EpsLeonid/lxe-twr/LXe_digitizer/TA12.jpg

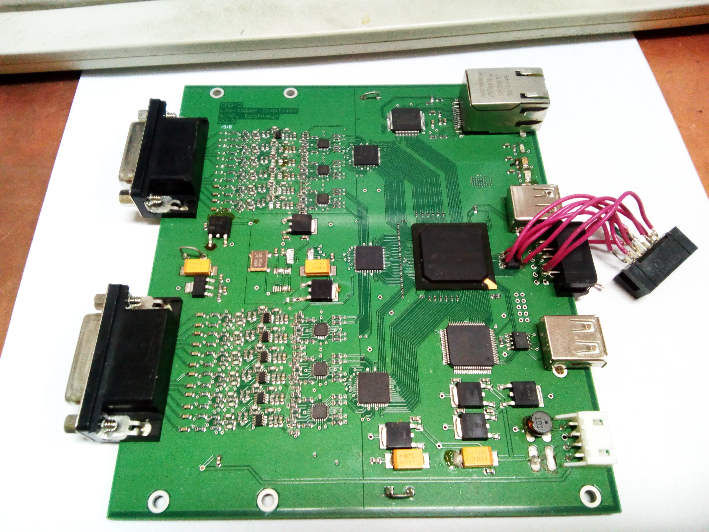
LXe_digitizer/TA12.jpg
