EpsLeonid/lxe-twr/IPT-LXe/Распайка/MyProject_BOM.xls

Designator | Footprint | Comment | Quantity | Layer | Rotation
UApu1 | PQFP-240 | EP3C25Q240C8N | 1 | Top | 270
