EpsLeonid/lxe-twr/IPT-LXe.xls

Comment | Description | Designator | LibRef | Quantity
0.1M |  | CApu1, CApu2, CLED, CLED1, CLED2, CLED3 | C | 6
0.1mkF |  | CCam2, CCam3, CCam4, CCam5 | C | 4
0.1 uF | Capacitor | C21, C22, C23, C24, C25, C26, C27, C29, C30, CAl1, CAl2, CAl3, CAl4, CAl5, CAl6, CAl7, CAl8, CAl9, CAl10, CAl11, CAl12, CAl13, CAl14, CAl15, CAl16, CApll1, CApll2, CApll3, CApll4 | C, Cap | 29
0.1uF |  | C1, C2, C3, C4, C5, C8, C9, C10, Cclk1, Cds1, Cgen1, Cser1, CSL3 | C | 13
1k |  | R1, R2, R3, R4 | R | 4
1K2 |  | RSL1, RSL4, RSL5, RSL8 | R | 4
1 nF |  | C31, C32, C33 | C | 3
2.2M |  | CApu3 | C | 1
5 V926(PLL) |  | UG3 | 5V926(PLL) | 1
10k |  | RApu1, RApu2, RApu3, Rpu1, Rpu2, Rpu3, Rpu4 | R | 7
10 uF |  | CApll5 | C POL | 1
12k |  | R9, R10 | R | 2
51 |  | R5, R6, R7, R8 | R | 4
56 |  | RSL2, RSL3, RSL6, RSL7 | R | 4
100mkF |  | CCam1, Csup2, Csup4, Csup7, Csup10, Csup13 | C POL | 6
200 |  | RLED1 | R | 1
300 |  | R11, R12, Rds4, RLED2, RLED3, Rser4, RSL9 | R | 7
BAV99 | Double diode | VD1, VD2 | BAV99 | 2
CAMAC | CAMAC module | P1 | CAMAC | 1
DM-2.4 |  | L1 | INDUCTOR | 1
DR |  | L4, L5 | L | 2
DS36C200 |  | UL1, UL2 | DS36C200 | 2
DS90LV001TM | 800 Mbps LVDS Buffer, 8-pin Narrow SOIC | Ds3, USer2 | DS90LV001TM | 2
DS92LV16TVHG | 16-Bit Bus LVDS Serializer/Deserializer - 25 - 80 MHz, 80-pin LQFP | UFL1, UFL2 | DS92LV16TVHG | 2
DS92LV1021AMSA | 16 MHz - 40 MHz 10-Bit Serializer, 28-pin SSOP-EIAJ | USer1 | DS92LV1021AMSA | 1
DS92LV1212AMSA | 16 MHz - 40 MHz 10-Bit Bus LVDS Random Lock Deserializer with Embedded Clock Recovery, 28-pin SSOP-EIAJ | Ds1 | DS92LV1212AMSA | 1
EP3C25Q240C8N | Cyclone III Family FPGA, 148 I/O Pins, 4 PLLs, 240-Pin PQFP, Speed Grade 8, Commercial Grade, Pb-Free | UApu1 | EP3C25Q240C8N | 1
EPCS4 | Serial configuration device for Cyclone (Altera) | UApu2 | EPCS1 | 1
Header 2 | Header, 2-Pin | Ds2 | Header 2 | 1
IDC-10 |  | UApu3 | IDC-10 | 1
KD212 |  | VD3, VD4 | AD110 | 2
KXO-97 | Crystal Oscillator (SMD) | UG1 | SG-636 | 1
LD1117-1.25V |  | Uref5 | NCP1117-3.3V | 1
LED |  | VDLED1, VDLED2, VDLED3, VDLED4, VDLED5, VDLED6, VDLED7, VDLED8, VDLED9, VDLED10, VDLED11 | AL307 | 11
LQH32 100mkH |  | L3 | DR | 1
LXT972A |  | U5 | LXT972A | 1
M47 |  | CSL1, CSL2, Csup1, Csup3, Csup5, Csup6, Csup8, Csup9, Csup11, Csup12, Csup14 | C | 11
MAX4651PP |  | UG2 | MAX4651PP | 1
NCP1117-2.5V |  | Uref4 | NCP1117-3.3V | 1
NCP1117-3.3V |  | Uref2, Uref3 | NCP1117-3.3V | 2
NCP1117-5V |  | Uref1 | NCP1117-3.3V | 1
R |  | Rc1, Rc2, Rc3, Rc4, Rc5, Rc6, Rc7, Rc8, Rc9, Rc10, Rc11, Rc12, Rc13, Rc14, Rc15, Rc16, Rc17, Rc18, Rc19, Rc20, Rc21, Rc22, Rc23, Rc24, Rc25, Rc26, Rc27, Rc28, Rc29, Rc30, Rc31, Rc32, Rc33, Rc34, Rc35, Rc36, Rc37, Rc38, Rc39, Rc40, Rc41, Rc42, Rc43, Rc44, Rc45, Rc46, Rc47, Rc48, Rc49, Rc50, Rc51, Rc52, Rc53, Rc54, Rc55, Rc56, Rc57, Rc58, Rc59, Rc60, Rc61, Rc62, Rc63, Rc64, Rc65, Rc66, Rds1, Rds2, Rds3, Rser1, Rser2, Rser3 | R | 72
TG110-S050N2 |  | T1 | TG110-S050N2 | 1
Tmp |  | X1, X2, X3, X4, X5, X6, X7, X8, X9, X10 | DRL | 10
USB_2A |  | USB_In1 | USB_2A | 1
USB_A |  | XDes, XSer, XSL | USB_A | 3
Value |  | R50, R51, R52, R53, R54, R55, R56, R57, R58, R59, R60, R61, R62, R63, R64 | R | 15
