EpsLeonid/lxe-twr/LXe_digitizer.xls

Comment | LibRef | Quantity
0.1M | C | 91
0.1M | C | 30
0.1uF | C | 2
1k | R | 4
1k | R | 42
1K2 | R | 4
2k7 | MLT | 2
2.2M | C | 1
5k6 | MLT | 1
5V926(PLL) | 5V926(PLL) | 1
10k | R | 7
20 | R | 24
20pF | C | 24
50k | R | 6
56 | R | 4
75 | MLT | 1
91 | R | 6
100 | R | 12
100mkF | C POL | 9
100mkH | DR | 8
110 | R | 1
120 | MLT | 2
150 | MLT | 6
200 | R | 1
220 | R | 12
240 | MLT | 1
240 | R | 12
270 | R | 6
300 | R | 2
360 | R | 6
500p | C | 12
510 | R | 1
510 | R | 12
AD8008 | AD8008 | 6
AD8014 | AD8005ART | 6
AD8138 | AD8138 | 6
AD8602 | AD8602 | 1
AD9432 | AD9432 | 6
BAV99 | BAV99 | 3
BFT25A | $NPN | 6
BFT92 | $PNP | 1
CWF-4-R | CWF-4-R | 1
DB25 | DB25 | 1
DS36C200 | DS36C200 | 2
DS90LV001 | DS90LV001 | 1
DS92LV16TVHG | DS92LV16TVHG | 1
EP3C25P240 | EP3C25P240 | 1
EPCS4 | EPCS1 | 1
IDC-10 | IDC-10 | 1
KS133G | D814 | 1
KXO-97 | SG-636 | 1
LD1117-1.25V | NCP1117-3.3V | 1
LED | AL307 | 3
LM337 | LM337 | 1
M47 | C | 23
M47 | C | 6
MAX4651PP | MAX4651PP | 1
NCP1117-2.5V | NCP1117-3.3V | 1
NCP1117-3.3V | NCP1117-3.3V | 3
NCP1117-5V | NCP1117-3.3V | 1
TRANSFORMER | TRANSFORMER | 1
USB_A | USB_A | 2
