EpsLeonid/lxe-twr/Комплектовка LXe.xls

TA6 |  |  |  |  | 1-я очередь | 2-я очередь
Comment | Quantity | Price |  |  | ЗЧУ | ТА6 | ИПТ-Lxe
0.1M | 91 | 45.5 |  |  | 100т.р | 1100т.р. | 100т.р. | 2014-04-14
0.1M | 30 | 15
0.1uF | 2 | 1
1k | 4 | 2
1k | 42 | 21
1K2 | 4 | 2
2k7 | 2 | 1
2.2M | 1 | 0.5
5k6 | 1 | 0.5
10k | 7 | 3.5
20 | 24 | 12
20pF | 24 | 12
50k | 6 | 3
56 | 4 | 2
75 | 1 | 0.5
91 | 6 | 3
100 | 12 | 6
100mkF | 9
100mkH | 8
110 | 1 | 0.5
120 | 2 | 1
150 | 6 | 3
200 | 1 | 0.5
220 | 12 | 6
240 | 1 | 0.5
240 | 12 | 6
270 | 6 | 3
300 | 2 | 1
360 | 6 | 3
500p | 12 | 6
510 | 1 | 0.5
510 | 12 | 6
M47 | 23 | 11.5
M47 | 6 | 3
5V926(PLL) | 1 | 200
AD8008 | 6 | 2157.6
AD8014 | 6 | 480
AD8138 | 6 | 1800
AD8602 | 1 | 60
AD9432 | 6 | 13200
BAV99 | 3 | 9
BFT25A | 6 | 90
BFT92 | 1 | 20
CWF-4-R | 1 | 15
DBR25 | 1 | 15
DS36C200 | 2 | 200
DS90LV001 | 1 | 96.8
DS92LV16TVHG | 1 | 951.2
EP3C25Q240C8N | 1 | 2500
EPCS4 | 1 | 150
IDC-10 | 1 | 2
KS133G | 1
KXO-97 | 1 | 130
LD1117-1.25V | 1 | 30
LED | 3 | 6
LM337 | 1 | 50
MAX4651PP | 1 | 100
NCP1117-2.5V | 1 | 30
NCP1117-3.3V | 3 | 90
NCP1117-5V | 1 | 30
TRANSFORMER | 1
USB_A | 2 | 40 | 22634.6 | 1131730
IPT-LXe
Comment | Quantity | Price
0.1M | 6 | 3
0.1mkF | 4 | 2
0.1 uF | 29 | 14.5
0.1uF | 13 | 6.5
1k | 4 | 2
1K2 | 4 | 2
1 nF | 3 | 1.5
2.2M | 1 | 0.5
10k | 7 | 3.5
10 uF | 1 | 0.5
12k | 2 | 1
51 | 4 | 2
56 | 4 | 2
100mkF | 6 | 3
200 | 1 | 0.5
300 | 7 | 3.5
R | 72 | 36
M47 | 11 | 5.5
5 V926(PLL) | 1 | 180.5
BAV99 | 2
CAMAC | 1
DM-2.4 | 1
DR | 2
DS36C200 | 2 | 200
DS90LV001TM | 4 | 387.2
DS92LV16TVHG | 22 | 20926.4
DS92LV1021AMSA | 3 | 1050
DS92LV1212AMSA | 1 | 350
EP3C25Q240C8N | 1 | 2500
EPCS4 | 1 | 150
Header 2 | 1
IDC-10 | 1 | 2
KD212 | 2
KXO-97 | 1 | 130
LD1117-1.25V | 1 | 30
LED | 11 | 22
LQH32 100mkH | 1
LXT972A | 1 | 125.9
MAX4651PP | 1 | 100
NCP1117-2.5V | 1 | 30
NCP1117-3.3V | 2 | 60
NCP1117-5V | 1 | 30
TG110-S050N2 | 1 | 250
Tmp | 10
USB_2A | 1 | 30
USB_A | 3 | 60
Value | 15 |  | 26703.5 | 80110.5
