EpsLeonid/lxe-twr/ADIS/Backup of Copy of ADIS.XLS

Part Type | Designator | Footprint | Description
2K | RR1 | T1
5V926(PLL) | UG2 | 16TSSOP | PLL
AD8138 | UB4 | 8SOIC150 | Differential ADC driver
AD8138 | UB12 | 8SOIC150 | Differential ADC driver
AD8138 | UB13 | 8SOIC150 | Differential ADC driver
AD8138 | UB5 | 8SOIC150 | Differential ADC driver
AD8138 | UB11 | 8SOIC150 | Differential ADC driver
AD8138 | UB8 | 8SOIC150 | Differential ADC driver
AD8138 | UB9 | 8SOIC150 | Differential ADC driver
AD8138 | UB14 | 8SOIC150 | Differential ADC driver
AD8138 | UB10 | 8SOIC150 | Differential ADC driver
AD8138 | UB16 | 8SOIC150 | Differential ADC driver
AD8138 | UB6 | 8SOIC150 | Differential ADC driver
AD8138 | UB15 | 8SOIC150 | Differential ADC driver
AD8138 | UB1 | 8SOIC150 | Differential ADC driver
AD8138 | UB2 | 8SOIC150 | Differential ADC driver
AD8138 | UB3 | 8SOIC150 | Differential ADC driver
AD8138 | UB7 | 8SOIC150 | Differential ADC driver
AD8602 | U1 | SO-8
AD9215 | UA3 | 28TSSOP | ADC
AD9215 | UA4 | 28TSSOP | ADC
AD9215 | UA1 | 28TSSOP | ADC
AD9215 | UA2 | 28TSSOP | ADC
AD9215 | UA7 | 28TSSOP | ADC
AD9215 | UA8 | 28TSSOP | ADC
AD9215 | UA5 | 28TSSOP | ADC
AD9215 | UA6 | 28TSSOP | ADC
AD9215 | UA13 | 28TSSOP | ADC
AD9215 | UA12 | 28TSSOP | ADC
AD9215 | UA14 | 28TSSOP | ADC
AD9215 | UA16 | 28TSSOP | ADC
AD9215 | UA15 | 28TSSOP | ADC
AD9215 | UA9 | 28TSSOP | ADC
AD9215 | UA10 | 28TSSOP | ADC
AD9215 | UA11 | 28TSSOP | ADC
ADG713 | UE11 | 16SOIC150
ADG713 | UE10 | 16SOIC150
ADG713 | UE9 | 16SOIC150
ADG713 | UE15 | 16SOIC150
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
SPX1117-3.3 | UP8 | TO-252
SPX1117-3.3 | U_Clk1 | TO-252
SPX1117-3.3 | UP11 | TO-252
SPX1117-3.3 | UP5 | TO-252
SPX1117-3.3 | UP6 | TO-252
USB_2A | XI5 | USBA-2J-M
USB_2A | XI4 | USBA-2J-M
USB_2A | XI6 | USBA-2J-M
USB_2A | XI2 | USBA-2J-M
USB_2A | XI1 | USBA-2J-M
USB_2A | XI3 | USBA-2J-M
USB_2A | XI8 | USBA-2J-M
USB_2A | XI7 | USBA-2J-M
USB_A | XFL1 | USB-A
USB_A | XL1 | usb-a
USB_A | XL2 | usb-a
XO-25.000MHz | UG4 | XO_SMT
chip1206 | C_clk2 | 1206
chip1206 | C_clk1 | 1206
chip1206 | C4 | CHIP1206
chip2225s | C2 | CHIP1206
chip2225s | C3 | CHIP1206
chip2225s | C1 | CHIP1206
