EpsLeonid/lxe-twr/LXe_digitizer/Распайка/New_LXe_twr_BOM.xlsx

Comment | Designator | Footprint | Layer | Quantity | Comp. size | H | Outline | Pack | Тип ленты | Feeder Type | Feeder | Feeder_ID | Speed | Tool | Tool Position | Z_pick |  | Z_ctrl | Примечание
Резисторы
100 | R29_Digit_1, R29_Digit_2, R29_Digit_3, R30_Digit_1, R30_Digit_2, R30_Digit_3, R31_Digit_1, R31_Digit_2, R31_Digit_3, R32_Digit_1, R32_Digit_2, R32_Digit_3, R33_Digit_1, R33_Digit_2, R33_Digit_3, R34_Digit_1, R34_Digit_2, R34_Digit_3, R35_Digit_1, R35_Digit_2, R35_Digit_3, R36_Digit_1, R36_Digit_2, R36_Digit_3, R39_Digit_1, R39_Digit_2, R39_Digit_3, R139_Digit_1, R139_Digit_2, R139_Digit_3 | 0402 | Bottom, Top | 30 | 0.5*1*0.35 | 0.35 | 1 | Катушка0402 | Картон | 0402 | 21 | 10479 |  | L-N016-020 | 1 | 0.6 |  | 0
20 | Rsh17_Digit_1, Rsh17_Digit_2, Rsh17_Digit_3, Rsh18_Digit_1, Rsh18_Digit_2, Rsh18_Digit_3, Rsh19_Digit_1, Rsh19_Digit_2, Rsh19_Digit_3, Rsh20_Digit_1, Rsh20_Digit_2, Rsh20_Digit_3, Rsh33_Digit_1, Rsh33_Digit_2, Rsh33_Digit_3, Rsh34_Digit_1, Rsh34_Digit_2, Rsh34_Digit_3, Rsh35_Digit_1, Rsh35_Digit_2, Rsh35_Digit_3, Rsh36_Digit_1, Rsh36_Digit_2, Rsh36_Digit_3 | 0603 | Bottom | 24 | 0.8*1.6*0.45 | 0.45 | 2 | Катушка8 | Картон | Block | 42.02 | 2117 |  | L-N025-030 | 2 | 0.2 |  | 0.2
51 | R1_Digit_1, R1_Digit_2, R1_Digit_3, R2_Digit_1, R2_Digit_2, R2_Digit_3, R3_Digit_1, R3_Digit_2, R3_Digit_3, R4_Digit_1, R4_Digit_2, R4_Digit_3,R45, R46 | 0603 | Top | 14 | 0.8*1.6*0.45 | 0.45 | 2 | Катушка8 | Картон | Block | 42.03 | 2117 |  | L-N025-030 | 2 | 0.2 |  | 0.2 | Замена катушки
68 | R37_Digit_1, R37_Digit_2, R37_Digit_3 | 0603 | Bottom | 3 | 0.8*1.6*0.45 | 0.45 | 2 |  |  | Table
91 | Rsh37_Digit_1, Rsh37_Digit_2, Rsh37_Digit_3, Rsh39_Digit_1, Rsh39_Digit_2, Rsh39_Digit_3, Rsh41_Digit_1, Rsh41_Digit_2, Rsh41_Digit_3, Rsh43_Digit_1, Rsh43_Digit_2, Rsh43_Digit_3, Rref1 | 0603 | Top | 13 | 0.8*1.6*0.45 | 0.45 | 2 |  |  | Block
100 | Rsh1_Digit_1, Rsh1_Digit_2, Rsh1_Digit_3, Rsh2_Digit_1, Rsh2_Digit_2, Rsh2_Digit_3, Rsh3_Digit_1, Rsh3_Digit_2, Rsh3_Digit_3, Rsh4_Digit_1, Rsh4_Digit_2, Rsh4_Digit_3,R21_Digit_1, R21_Digit_2, R21_Digit_3, R22_Digit_1, R22_Digit_2, R22_Digit_3, R23_Digit_1, R23_Digit_2, R23_Digit_3, R24_Digit_1, R24_Digit_2, R24_Digit_3, R25_Digit_1, R25_Digit_2, R25_Digit_3, R26_Digit_1, R26_Digit_2, R26_Digit_3, R27_Digit_1, R27_Digit_2, R27_Digit_3, R28_Digit_1, R28_Digit_2, R28_Digit_3, RSL1, RSL2 | 0603 | Bottom, Top | 36 | 0.8*1.6*0.45 | 0.45 | 2 | Катушка8 | Картон | Block | 42.04 | 2117 |  | L-N025-030 | 2 | 0.2 |  | 0.3
110 | RFL4 | 0603 | Top | 1 | 0.8*1.6*0.45 | 0.45 | 2 |  |  | Table
120 | Rref2 | 0603 | Top | 1 | 0.8*1.6*0.45 | 0.45 | 2 |  |  | Table
180 | R48, R49, R50 | 0603 | Top | 3 | 0.8*1.6*0.45 | 0.45 | 2 | Катушка8 | Картон | Block | 42.05 | 2117 |  | L-N025-030 | 2 | 0.2 |  | 0.2
200 | R44, RLED1 | 0603 | Bottom, Top | 2 | 0.8*1.6*0.45 | 0.45 | 2 | Катушка8 | Картон | Block | 42.06 | 2117 |  | L-N025-030 | 2 | 0.2 |  | 0.3
220 | Rsh45_Digit_1, Rsh45_Digit_2, Rsh45_Digit_3, Rsh46_Digit_1, Rsh46_Digit_2, Rsh46_Digit_3, Rsh47_Digit_1, Rsh47_Digit_2, Rsh47_Digit_3, Rsh48_Digit_1, Rsh48_Digit_2, Rsh48_Digit_3, Rsh49_Digit_1, Rsh49_Digit_2, Rsh49_Digit_3, Rsh50_Digit_1, Rsh50_Digit_2, Rsh50_Digit_3, Rsh51_Digit_1, Rsh51_Digit_2, Rsh51_Digit_3, Rsh52_Digit_1, Rsh52_Digit_2, Rsh52_Digit_3 | 0603 | Top | 24 | 0.8*1.6*0.45 | 0.45 | 2 |  |  | Block
240 | Rsh25_Digit_1, Rsh25_Digit_2, Rsh25_Digit_3, Rsh26_Digit_1, Rsh26_Digit_2, Rsh26_Digit_3, Rsh27_Digit_1, Rsh27_Digit_2, Rsh27_Digit_3, Rsh28_Digit_1, Rsh28_Digit_2, Rsh28_Digit_3, Rsh29_Digit_1, Rsh29_Digit_2, Rsh29_Digit_3, Rsh30_Digit_1, Rsh30_Digit_2, Rsh30_Digit_3, Rsh31_Digit_1, Rsh31_Digit_2, Rsh31_Digit_3, Rsh32_Digit_1, Rsh32_Digit_2, Rsh32_Digit_3 | 0603 | Top | 24 | 0.8*1.6*0.45 | 0.45 | 2 |  |  | Block
270 | Rsh53_Digit_1, Rsh53_Digit_2, Rsh53_Digit_3, Rsh55_Digit_1, Rsh55_Digit_2, Rsh55_Digit_3, Rsh57_Digit_1, Rsh57_Digit_2, Rsh57_Digit_3, Rsh59_Digit_1, Rsh59_Digit_2, Rsh59_Digit_3 | 0603 | Top | 12 | 0.8*1.6*0.45 | 0.45 | 2 |  |  | Block
300 | RLED2, RLED3 | 0603 | Top | 2 | 0.8*1.6*0.45 | 0.45 | 2 |  |  | Table
360 | Rsh54_Digit_1, Rsh54_Digit_2, Rsh54_Digit_3, Rsh56_Digit_1, Rsh56_Digit_2, Rsh56_Digit_3, Rsh58_Digit_1, Rsh58_Digit_2, Rsh58_Digit_3, Rsh60_Digit_1, Rsh60_Digit_2, Rsh60_Digit_3 | 0603 | Top | 12 | 0.8*1.6*0.45 | 0.45 | 2 |  |  | Block
510 | R5_Digit_1, R5_Digit_2, R5_Digit_3, R6_Digit_1, R6_Digit_2, R6_Digit_3, R7_Digit_1, R7_Digit_2, R7_Digit_3, R8_Digit_1, R8_Digit_2, R8_Digit_3, R9_Digit_1, R9_Digit_2, R9_Digit_3, R10_Digit_1, R10_Digit_2, R10_Digit_3, R11_Digit_1, R11_Digit_2, R11_Digit_3, R12_Digit_1, R12_Digit_2, R12_Digit_3, RFL2 | 0603 | Top, Bottom | 25 | 0.8*1.6*0.45 | 0.45 | 2 |  |  | Block
1k | R13_Digit_1, R13_Digit_2, R13_Digit_3, R14_Digit_1, R14_Digit_2, R14_Digit_3, R15_Digit_1, R15_Digit_2, R15_Digit_3, R16_Digit_1, R16_Digit_2, R16_Digit_3, R17_Digit_1, R17_Digit_2, R17_Digit_3, R18_Digit_1, R18_Digit_2, R18_Digit_3, R19_Digit_1, R19_Digit_2, R19_Digit_3, R20_Digit_1, R20_Digit_2, R20_Digit_3, Rsh5_Digit_1, Rsh5_Digit_2, Rsh5_Digit_3, Rsh6_Digit_1, Rsh6_Digit_2, Rsh6_Digit_3, Rsh7_Digit_1, Rsh7_Digit_2, Rsh7_Digit_3, Rsh8_Digit_1, Rsh8_Digit_2, Rsh8_Digit_3, Rsh9_Digit_1, Rsh9_Digit_2, Rsh9_Digit_3, Rsh10_Digit_1, Rsh10_Digit_2, Rsh10_Digit_3, Rsh11_Digit_1, Rsh11_Digit_2, Rsh11_Digit_3, Rsh12_Digit_1, Rsh12_Digit_2, Rsh12_Digit_3, Rsh13_Digit_1, Rsh13_Digit_2, Rsh13_Digit_3, Rsh14_Digit_1, Rsh14_Digit_2, Rsh14_Digit_3, Rsh15_Digit_1, Rsh15_Digit_2, Rsh15_Digit_3, Rsh16_Digit_1, Rsh16_Digit_2, Rsh16_Digit_3, Rsh21_Digit_1, Rsh21_Digit_2, Rsh21_Digit_3, Rsh22_Digit_1, Rsh22_Digit_2, Rsh22_Digit_3, Rsh23_Digit_1, Rsh23_Digit_2, Rsh23_Digit_3, Rsh24_Digit_1, Rsh24_Digit_2, Rsh24_Digit_3, Rsh38_Digit_1, Rsh38_Digit_2, Rsh38_Digit_3, Rsh40_Digit_1, Rsh40_Digit_2, Rsh40_Digit_3, Rsh42_Digit_1, Rsh42_Digit_2, Rsh42_Digit_3, Rsh44_Digit_1, Rsh44_Digit_2, Rsh44_Digit_3, ExtReset1, R41_Digit_1, R41_Digit_2, R41_Digit_3, R42, RFL3, RFL5 | 0603 | Bottom, Top | 91 | 0.8*1.6*0.45 | 0.45 | 2 | Катушка8 | Картон | Block | 42.11 | 2117 |  | L-N025-030 | 2 | 0.2 |  | 0.1
5k6 | R38_Digit_1, R38_Digit_2, R38_Digit_3 | 0603 | Bottom | 3 | 0.8*1.6*0.45 | 0.45 | 2 |  |  | Table
9.1k | R40_Digit_1, R40_Digit_2, R40_Digit_3 | 0603 | Bottom | 3 | 0.8*1.6*0.45 | 0.45 | 2 |  |  | Table
10k | R37, R38, R39, R40, R41, R43, R51, R52, R53 | 0603 | Bottom, Top | 9 | 0.8*1.6*0.45 | 0.45 | 2 | Катушка8 | Картон | Block | 50.07 | 2120 |  | L-N025-030 | 2 | 0.2 |  | 0.3
22.1k | R47 | 0603 | Top | 1 | 0.8*1.6*0.45 | 0.45 | 2 | Катушка8 | Картон | Table | 957 |  |  | L-N025-030 | 2 | 1 |  | 0.1
Конденсаторы
0.1uF | C17, C18, C19, C20, C21, C22, C23, C24, C25, C26, C27, C28, C29, C30, C31, C32, C33, C34, C35, C36, C37, C38, C39, C40, C41, C42, C43, C44, C45, C46, C47, C48, C49, C50, C51, C52, C137, C138, C139, C140, C153, C154, C155, C156 | 0402 | Bottom | 44 | 0.5*1*0.55 | 0.55 | 1 | Катушка0402 | Картон | 0402 | 23 | 10575 |  | L-N016-020 | 1 | 0.4 | 0.5 | 0.1
20pF | Csh13_Digit_1, Csh13_Digit_2, Csh13_Digit_3, Csh14_Digit_1, Csh14_Digit_2, Csh14_Digit_3, Csh15_Digit_1, Csh15_Digit_2, Csh15_Digit_3, Csh16_Digit_1, Csh16_Digit_2, Csh16_Digit_3, Csh17_Digit_1, Csh17_Digit_2, Csh17_Digit_3, Csh18_Digit_1, Csh18_Digit_2, Csh18_Digit_3, Csh19_Digit_1, Csh19_Digit_2, Csh19_Digit_3, Csh20_Digit_1, Csh20_Digit_2, Csh20_Digit_3, Csh25_Digit_1, Csh25_Digit_2, Csh25_Digit_3, Csh26_Digit_1, Csh26_Digit_2, Csh26_Digit_3, Csh27_Digit_1, Csh27_Digit_2, Csh27_Digit_3, Csh28_Digit_1, Csh28_Digit_2, Csh28_Digit_3, Csh29_Digit_1, Csh29_Digit_2, Csh29_Digit_3, Csh30_Digit_1, Csh30_Digit_2, Csh30_Digit_3, Csh31_Digit_1, Csh31_Digit_2, Csh31_Digit_3, Csh32_Digit_1, Csh32_Digit_2, Csh32_Digit_3 | 0603 | Top | 48 | 0.8*1.6*0.8 | 0.8 | 2 |  |  | Short
56pF | C9_Digit_1, C9_Digit_2, C9_Digit_3, C10_Digit_1, C10_Digit_2, C10_Digit_3, C11_Digit_1, C11_Digit_2, C11_Digit_3, C12_Digit_1, C12_Digit_2, C12_Digit_3, C13_Digit_1, C13_Digit_2, C13_Digit_3, C14_Digit_1, C14_Digit_2, C14_Digit_3, C15_Digit_1, C15_Digit_2, C15_Digit_3, C16_Digit_1, C16_Digit_2, C16_Digit_3 | 0603 | Bottom | 24 | 0.8*1.6*0.8 | 0.8 | 2 |  |  | Short
0.1uF | Csh9_Digit_1, Csh9_Digit_2, Csh9_Digit_3, Csh10_Digit_1, Csh10_Digit_2, Csh10_Digit_3, Csh11_Digit_1, Csh11_Digit_2, Csh11_Digit_3, Csh12_Digit_1, Csh12_Digit_2, Csh12_Digit_3, Csh21_Digit_1, Csh21_Digit_2, Csh21_Digit_3, Csh22_Digit_1, Csh22_Digit_2, Csh22_Digit_3, Csh23_Digit_1, Csh23_Digit_2, Csh23_Digit_3, Csh24_Digit_1, Csh24_Digit_2, Csh24_Digit_3, Cudig1_Digit_1, Cudig2_Digit_1, Cudig3_Digit_1, Cudig4_Digit_1, Cudig5_Digit_1, Cudig6_Digit_1, Cudig7_Digit_1, Cudig8_Digit_1, Cudig9_Digit_1, Cudig9_Digit_2, Cudig9_Digit_3, Cudig10_Digit_1, Cudig10_Digit_2, Cudig10_Digit_3, Cudig11_Digit_1, Cudig11_Digit_2, Cudig11_Digit_3, C2_Digit_1, C2_Digit_2, C2_Digit_3, C4_Digit_1, C4_Digit_2, C4_Digit_3, C54, C55, C56, C57, C58, C59, C60, C61, C62, Cclk1, Cgen1, CIO1, CIO2, CIO3, CIO4, CLED2, CLED3, CLED4, Cudig1_Digit_2, Cudig1_Digit_3, Cudig2_Digit_2, Cudig2_Digit_3, Cudig3_Digit_2, Cudig3_Digit_3, Cudig4_Digit_2, Cudig4_Digit_3, Cudig5_Digit_2, Cudig5_Digit_3, Cudig6_Digit_2, Cudig6_Digit_3, Cudig7_Digit_2, Cudig7_Digit_3, Cudig8_Digit_2, Cudig8_Digit_3, CLED1 | 0603 | Bottom | 82 | 0.8*1.6*0.8 | 0.8 | 2 | Катушка8 | Картон | Block | 58.03 | 2153 |  | L-N025-030 | 2 | -0.5 | 0.5 | 0.4
0.150uF | Csh1_Digit_1, Csh1_Digit_2, Csh1_Digit_3, Csh2_Digit_1, Csh2_Digit_2, Csh2_Digit_3, Csh3_Digit_1, Csh3_Digit_2, Csh3_Digit_3, Csh4_Digit_1, Csh4_Digit_2, Csh4_Digit_3, Csh5_Digit_1, Csh5_Digit_2, Csh5_Digit_3, Csh6_Digit_1, Csh6_Digit_2, Csh6_Digit_3, Csh7_Digit_1, Csh7_Digit_2, Csh7_Digit_3, Csh8_Digit_1, Csh8_Digit_2, Csh8_Digit_3 | 0603 | Top | 24 | 0.8*1.6*0.8 | 0.8 | 2 |  |  | Block |  |  |  |  |  |  |  |  | замена на 0.22
0.47uF | C84_Digit_1, C84_Digit_2, C84_Digit_3, Csup1, Csup3, Csup4, Csup5, Csup6, Csup7, Csup8, Csup16, Csup17, Csup18, Csup19, Csup20, Csup21, Csup22, Csup23, Csup25 | 0603 | Bottom, Top | 19 | 0.8*1.6*0.8 | 0.8 | 2 | Катушка8 | Картон | Block | 58.04 | 2153 |  | L-N025-030 | 2 | -0.5 | 0.7 | 0.6
1uF | Csh33_Digit_1, Csh33_Digit_2, Csh33_Digit_3, Csh34_Digit_1, Csh34_Digit_2, Csh34_Digit_3, Csh35_Digit_1, Csh35_Digit_2, Csh35_Digit_3, Csh36_Digit_1, Csh36_Digit_2, Csh36_Digit_3 | 0603 | Top | 12 | 0.8*1.6*0.8 | 0.8 | 2 | Катушка8 | Картон | Block | 58.05 | 2153 |  | L-N025-030 | 2 | -0.5 | 0.5 | 0.4
10uF | C1_Digit_1, C1_Digit_2, C1_Digit_3, C3_Digit_1, C3_Digit_2, C3_Digit_3 | 0603 | Bottom | 6 | 0.8*1.6*0.8 | 0.8 | 2 |  |  | Table
100uF | Csup2, Csup9, Csup10, Csup11, Csup12, Csup13, Csup14, Csup15, Csup24, Csup_1 | TantD | Bottom, Top | 10 | 4.3*7.3*2.9 | 2.9 | 13 |  |  | Table
Микросхем
5V926(PLL) | UG3 | TSSOP-16 | Top | 1 | 5*6.4*1.2 | 1.2 |  |  |  | Vibe
AD4932-2 | U1_Digit_1, U1_Digit_2, U1_Digit_3, U2_Digit_1, U2_Digit_2, U2_Digit_3 | CP-24-13 | Top | 6 | 3*3*1 | 1 |  |  |  | Table
AD8005ART | Usup1_Digit_1, Usup1_Digit_2, Usup1_Digit_3 | SOT23-5 | Bottom | 3 | 3*3*1.45 | 1.45 | 41 |  |  | Table
AD8014 | Ush1_Digit_1, Ush1_Digit_2, Ush1_Digit_3, Ush2_Digit_1, Ush2_Digit_2, Ush2_Digit_3, Ush3_Digit_1, Ush3_Digit_2, Ush3_Digit_3, Ush4_Digit_1, Ush4_Digit_2, Ush4_Digit_3 | RT-5 | Bottom | 12 | 3*1.7*1.45 | 1.45 |  |  |  | Table
AD8039 | Ush5_Digit_1, Ush5_Digit_2, Ush5_Digit_3, Ush6_Digit_1, Ush6_Digit_2, Ush6_Digit_3, Ush7_Digit_1, Ush7_Digit_2, Ush7_Digit_3, Ush8_Digit_1, Ush8_Digit_2, Ush8_Digit_3 | SOT23-8 | Top | 12 | 2.9*2.8*1.45 | 1.45 |  |  |  | Table
ADC3424 / ADC3444 | U3_Digit_1, U3_Digit_2, U3_Digit_3 | PQFN-56 | Top | 3 | 8.15*8.15*1 | 1 |  |  |  | Table
DS90LV001 | UFL2 | 8SO200 | Top | 1 | 6.2*5*1.75 | 1.75 | 20 |  |  | Vibe
DS92LV16TVHG | UFL1 | VHG80A_N | Top | 1 | 14.2*14.2*1.6 | 1.6 |  |  |  | Table
EP4CE40F23C7 | U4 | FBGA484 | Top | 1 | 23*23*2.4 | 2.4 | 58 |  |  | Table | 802 |  | L-N109-140 | 4 |  |  | 1
EPCS16SI8N | U6 | 8SO200 | Top | 1 | 4.9*6*1.75 | 1.75 | 20 |  |  | Vibe
IDT_854105I | Uclk1 | TSSOP-16 | Top | 1 | 5*6.4*1.2 | 1.2 |  |  |  | Vibe
IS61WV6416DBLL_BGA | RAM_ | TF-BGA 48L 6x8mm | Bottom | 1 | 6*8*1.2 | 1.2 |  |  |  | Table
KXO-97 | UG1 | SG-636 | Top | 1 | 7*5*1.2 | 1.2 |  |  |  | Table
LD1117-1.25V | Uref7 | 369A-13 | Top | 1 | 6.58*9.7*2.3 | 2.3 |  |  |  | Table
LM337 | Uref8 | SOT223_N | Top | 1 | 6.5*7*1.75 | 1.75 |  |  |  | Table
LXT972A | U8 | TQFP-64 | Top | 1 | 12*12*1.6 | 1.6 | 56 |  |  | Table
NCP1117-1.8V | Uref1, Uref3 | 369A-13 | Top | 2 | 6.58*9.7*2.3 | 2.3 |  |  |  | Table
NCP1117-2.5V | Uref6 | 369A-13 | Top | 1 | 6.58*9.7*2.3 | 2.3 |  |  |  | Table
NCP1117-3.3V | Uref4, Uref5 | 369A-13 | Top | 2 | 6.58*9.7*2.3 | 2.3 |  |  |  | Table
NCP1117-5V | Uref2 | 369A-13 | Top | 1 | 6.58*9.7*2.3 | 2.3 |  |  |  | Table
Ручная установка
100mkH | LrefGND1_Digit_1, LrefGND1_Digit_2, LrefGND1_Digit_3 | 0805 | Bottom | 3
DR | L1, L2 | 0805 | Bottom | 2
100mkH | Lref1 | SDR0604 | Top | 2
LED | VDLED1, VDLED4 | LED0805 | Top | 2
LED | VDLED2, VDLED3 | LED1206 | Top | 2
CWF-4-R | LX1 | CWF-4R | Top | 1
DHR-26F | CSAin_1, CSAin_2 | DHR-F-26 | Top | 2
HR961160C | JEth1 | HR961160C | Top | 1
JTAG | U7 | IDC10 | Top | 1
USB_A | XFL, XSL | USB2.5-2H4B | Top | 2
SW-SPST | S1, S2, S3 | SPST-2 | Top | 3
