EpsLeonid/lxe-twr/LXe_digitizer/Комплектовка.xlsx

Наименование | Цена | Кол-во | Сумма | Доллар
ADC3424 | 10200 | 3 | 30600 | 68
AD8039 | 136 | 12 | 1632
AD8014 | 204 | 12 | 2448
ADA4932-2 | 544 | 6 | 3264
ADA4807-1 | 204 | 3 | 612
EP4CE40F23C7 | 10200 | 1 | 10200
EPCS16 | 1700 | 1 | 1700
IDT_854105I | 136 | 1 | 136
DS92LV16TVHG | 1836 | 1 | 1836
IS61WV6416DBLL_BGA | 272 | 1 | 272
LXT972A | 544 | 1 | 544
HR961160C | 272 | 1 | 272
 |  | Итого | 53516
Изготовление плат | 3740 | 25 | 93500
 |  | Кол-во плат | Общая сумма
 |  | 25 | 1431400
