EpsLeonid/lxe-twr/LXe_digitizer/Распайка/New_LXe_twr.xls

Comment | Designator | Footprint | LibRef | Quantity
20pF | Csh2_Digit_1, Csh2_Digit_2, Csh2_Digit_3, Csh2_Digit_4, Csh2_Digit_5, Csh2_Digit_6, Csh3_Digit_1, Csh3_Digit_2, Csh3_Digit_3, Csh3_Digit_4, Csh3_Digit_5, Csh3_Digit_6, Csh5_Digit_1, Csh5_Digit_2, Csh5_Digit_3, Csh5_Digit_4, Csh5_Digit_5, Csh5_Digit_6, Csh6_Digit_1, Csh6_Digit_2, Csh6_Digit_3, Csh6_Digit_4, Csh6_Digit_5, Csh6_Digit_6 | chip0603 | C | 24
500p | Cdig1_Digit_1, Cdig1_Digit_2, Cdig1_Digit_3, Cdig1_Digit_4, Cdig1_Digit_5, Cdig1_Digit_6, Cdig2_Digit_1, Cdig2_Digit_2, Cdig2_Digit_3, Cdig2_Digit_4, Cdig2_Digit_5, Cdig2_Digit_6 | chip0603 | C | 12
0.1uF | C_ref1_Digit_1, C_ref1_Digit_2, C_ref1_Digit_3, C_ref1_Digit_4, C_ref1_Digit_5, C_ref1_Digit_6, Csh1_Digit_1, Csh1_Digit_2, Csh1_Digit_3, Csh1_Digit_4, Csh1_Digit_5, Csh1_Digit_6, Csh4_Digit_1, Csh4_Digit_2, Csh4_Digit_3, Csh4_Digit_4, Csh4_Digit_5, Csh4_Digit_6, Csh9_Digit_1, Csh9_Digit_2, Csh9_Digit_3, Csh9_Digit_4, Csh9_Digit_5, Csh9_Digit_6, Csh10_Digit_1, Csh10_Digit_2, Csh10_Digit_3, Csh10_Digit_4, Csh10_Digit_5, Csh10_Digit_6 | chip0603 | C | 30
M47 | Csh8_Digit_1, Csh8_Digit_2, Csh8_Digit_3, Csh8_Digit_4, Csh8_Digit_5, Csh8_Digit_6 | chip0603 | C | 6
0.1uF | CApu1, CApu2, CdigClk1_Digit_1, CdigClk1_Digit_2, CdigClk1_Digit_3, CdigClk1_Digit_4, CdigClk1_Digit_5, CdigClk1_Digit_6, CFL1, CIO1, CIO2, CIO3, CIO4, CLED, CLED1, CLED2, CLED3, Cpu1, Cpu2, Cpu3, Cpu4, Cpu5, Cpu6, Cpu7, Cpu8, Cpu9, Cpu10, Cpu11, Cpu12, Cpu13, Cpu14, Cpu15, Cpu16, Cpu17, Cpu18, Cpu19, Cpu20, Cpu21, Cpu22, Cpu23, Cpu24, Cpu25, Cpu26, Cpu27, Cpu28, Cpu29, Cpu30, Cpu31, Cpu32, Cudig1_Digit_1, Cudig1_Digit_2, Cudig1_Digit_3, Cudig1_Digit_4, Cudig1_Digit_5, Cudig1_Digit_6, Cudig2_Digit_1, Cudig2_Digit_2, Cudig2_Digit_3, Cudig2_Digit_4, Cudig2_Digit_5, Cudig2_Digit_6, Cudig3_Digit_1, Cudig3_Digit_2, Cudig3_Digit_3, Cudig3_Digit_4, Cudig3_Digit_5, Cudig3_Digit_6, Cudig4_Digit_1, Cudig4_Digit_2, Cudig4_Digit_3, Cudig4_Digit_4, Cudig4_Digit_5, Cudig4_Digit_6, Cudig5_Digit_1, Cudig5_Digit_2, Cudig5_Digit_3, Cudig5_Digit_4, Cudig5_Digit_5, Cudig5_Digit_6, Cudig6_Digit_1, Cudig6_Digit_2, Cudig6_Digit_3, Cudig6_Digit_4, Cudig6_Digit_5, Cudig6_Digit_6, Cudig7_Digit_1, Cudig7_Digit_2, Cudig7_Digit_3, Cudig7_Digit_4, Cudig7_Digit_5, Cudig7_Digit_6, Cclk, Cgen | chip0805 | C | 93
M47 | CG1, CG2, CG3, CG4, CG5, CG6, CL1, CL2, Cref1, Csup, Csup1, Csup4, Csup6, Csup7, Csup9, Csup10, Csup12, Csup13, Csup15, Csup16, Csup17, Csup18, Csup20 | chip0805 | C | 23
2.2M | CApu3 | chip0805 | C | 1
100mkF | Csup2, Csup3, Csup5, Csup8, Csup11, Csup14, Csup19, Csup21, Csup_1 | CEL-SMD300 | C POL | 9
100mkH | Lref1, Lref2, LrefGND1_Digit_1, LrefGND1_Digit_2, LrefGND1_Digit_3, LrefGND1_Digit_4, LrefGND1_Digit_5, LrefGND1_Digit_6 | SDR0604 | DR | 8
20 | Rsh4_Digit_1, Rsh4_Digit_2, Rsh4_Digit_3, Rsh4_Digit_4, Rsh4_Digit_5, Rsh4_Digit_6, Rsh7_Digit_1, Rsh7_Digit_2, Rsh7_Digit_3, Rsh7_Digit_4, Rsh7_Digit_5, Rsh7_Digit_6, Rsh17_Digit_1, Rsh17_Digit_2, Rsh17_Digit_3, Rsh17_Digit_4, Rsh17_Digit_5, Rsh17_Digit_6, Rsh18_Digit_1, Rsh18_Digit_2, Rsh18_Digit_3, Rsh18_Digit_4, Rsh18_Digit_5, Rsh18_Digit_6 | chip0603 | R | 24
91 | Rsh8_Digit_1, Rsh8_Digit_2, Rsh8_Digit_3, Rsh8_Digit_4, Rsh8_Digit_5, Rsh8_Digit_6 | chip0603 | R | 6
100 | Rdig1_Digit_1, Rdig1_Digit_2, Rdig1_Digit_3, Rdig1_Digit_4, Rdig1_Digit_5, Rdig1_Digit_6, Rdig2_Digit_1, Rdig2_Digit_2, Rdig2_Digit_3, Rdig2_Digit_4, Rdig2_Digit_5, Rdig2_Digit_6 | chip0603 | R | 12
220 | Rsh10_Digit_1, Rsh10_Digit_2, Rsh10_Digit_3, Rsh10_Digit_4, Rsh10_Digit_5, Rsh10_Digit_6, Rsh11_Digit_1, Rsh11_Digit_2, Rsh11_Digit_3, Rsh11_Digit_4, Rsh11_Digit_5, Rsh11_Digit_6 | chip0603 | R | 12
240 | Rsh5_Digit_1, Rsh5_Digit_2, Rsh5_Digit_3, Rsh5_Digit_4, Rsh5_Digit_5, Rsh5_Digit_6, Rsh6_Digit_1, Rsh6_Digit_2, Rsh6_Digit_3, Rsh6_Digit_4, Rsh6_Digit_5, Rsh6_Digit_6 | chip0603 | R | 12
270 | Rsh13_Digit_1, Rsh13_Digit_2, Rsh13_Digit_3, Rsh13_Digit_4, Rsh13_Digit_5, Rsh13_Digit_6 | chip0603 | R | 6
360 | Rsh14_Digit_1, Rsh14_Digit_2, Rsh14_Digit_3, Rsh14_Digit_4, Rsh14_Digit_5, Rsh14_Digit_6 | chip0603 | R | 6
510 | Rsh15_Digit_1, Rsh15_Digit_2, Rsh15_Digit_3, Rsh15_Digit_4, Rsh15_Digit_5, Rsh15_Digit_6, Rsh16_Digit_1, Rsh16_Digit_2, Rsh16_Digit_3, Rsh16_Digit_4, Rsh16_Digit_5, Rsh16_Digit_6 | chip0603 | R | 12
1k | Rsh0_Digit_1, Rsh0_Digit_2, Rsh0_Digit_3, Rsh0_Digit_4, Rsh0_Digit_5, Rsh0_Digit_6, Rsh1_Digit_1, Rsh1_Digit_2, Rsh1_Digit_3, Rsh1_Digit_4, Rsh1_Digit_5, Rsh1_Digit_6, Rsh2_Digit_1, Rsh2_Digit_2, Rsh2_Digit_3, Rsh2_Digit_4, Rsh2_Digit_5, Rsh2_Digit_6, Rsh3_Digit_1, Rsh3_Digit_2, Rsh3_Digit_3, Rsh3_Digit_4, Rsh3_Digit_5, Rsh3_Digit_6, Rsh9_Digit_1, Rsh9_Digit_2, Rsh9_Digit_3, Rsh9_Digit_4, Rsh9_Digit_5, Rsh9_Digit_6, Rsh19_Digit_1, Rsh19_Digit_2, Rsh19_Digit_3, Rsh19_Digit_4, Rsh19_Digit_5, Rsh19_Digit_6, Rsh20_Digit_1, Rsh20_Digit_2, Rsh20_Digit_3, Rsh20_Digit_4, Rsh20_Digit_5, Rsh20_Digit_6 | chip0603 | R | 42
50k | Rcm1_Digit_1, Rcm1_Digit_2, Rcm1_Digit_3, Rcm1_Digit_4, Rcm1_Digit_5, Rcm1_Digit_6 | chip0603 | R | 6
56 | RL2, RL3, RL6, RL7 | chip0805 | R | 4
75 | Rref1 | CHIP0805 | R | 1
110 | RFL5 | CHIP0805 | R | 1
120 | RG, Rref2 | chip0805 | R | 2
150 | RG1, RG2, RG3, RG4, RG5, RG6 | chip0805 | R | 6
200 | RLED1 | CHIP0805 | R | 1
240 | RR2 | CHIP0805 | R | 1
300 | RLED2, RLED3 | CHIP0805 | R | 2
510 | RFL4 | CHIP0805 | R | 1
1k | RDFL, RFL1, RFL2 | chip0805 | R | 3
1K2 | RL1, RL4, RL5, RL8 | chip0805 | R | 4
2k7 | RR1, RR3 | CHIP0805 | R | 2
5k6 | RR4 | CHIP0805 | R | 1
10k | RApu1, RApu2, RApu3, Rpu1, Rpu2, Rpu3, Rpu4 | chip0805 | R | 7
KS133G | VDL1 | DIODE-SMA |  | 1
BFT25A | VTG1, VTG2, VTG3, VTG4, VTG5, VTG6 | SOT23_bt |  | 6
BFT92 | VTG | SOT23_bt |  | 1
5V926(PLL) | UG3 | TSSOP16 | 5V926(PLL) | 1
AD8014 | Uamp1_Digit_1, Uamp1_Digit_2, Uamp1_Digit_3, Uamp1_Digit_4, Uamp1_Digit_5, Uamp1_Digit_6 | SOT23-5 | AD8005ART | 6
AD8008 | Uamp2_Digit_1, Uamp2_Digit_2, Uamp2_Digit_3, Uamp2_Digit_4, Uamp2_Digit_5, Uamp2_Digit_6 | RM-8 | AD8008 | 6
AD8138 | Ush1_Digit_1, Ush1_Digit_2, Ush1_Digit_3, Ush1_Digit_4, Ush1_Digit_5, Ush1_Digit_6 | 8SO200 | AD8138 | 6
AD8602 | UREF6 | SO-8 | AD8602 | 1
AD9432 | U1_Digit_1, U1_Digit_2, U1_Digit_3, U1_Digit_4, U1_Digit_5, U1_Digit_6 | LQFP52 | AD9432 | 6
LED | VDLED1, VDLED2, VDLED3 | LED2P5_H | AL307 | 3
BAV99 | UDFL1, UDFL2, UDFL3 | SOT323 | BAV99 | 3
DS36C200 | UL1, UL2 | 14SO200 | DS36C200 | 2
DS90LV001 | UFL2 | 8SO200 | DS90LV001 | 1
DS92LV16TVHG | UFL1 | VHG80A_N | DS92LV16TVHG | 1
EP3C25P240 | Upu1 | PQFP240_M | EP3C25P240 | 1
EPCS4 | UApu2 | 8SO200 | EPCS1 | 1
MAX4651PP | UG2 | 16SOIC150 | MAX4651PP | 1
KXO-97 | UG1 | SG-636 | SG-636 | 1
LM337 | Uref7 | TO-220-AB | LM337 | 1
NCP1117-3.3V | Uref2, Uref3, Uref8 | TO-252 | NCP1117-3.3V | 3
NCP1117-5V | Uref1 | SOT-223 | NCP1117-3.3V | 1
LD1117-1.25V | Uref5 | TO-252 | NCP1117-3.3V | 1
NCP1117-2.5V | Uref4 | TO-252 | NCP1117-3.3V | 1
IDC-10 | UApu3 | IDC10MR | IDC-10 | 1
CWF-4-R | LX1 | CWF-4R | CWF-4-R | 1
DB25 | UCSA_in | DBR-F-25 | DB25 | 1
USB_A | LX2, XFL1 | USB-A | USB_A | 2
