EpsLeonid/lxe-twr/(list of files, cad)

Other CAD files:
Altera/TA12_digitizer/Ext_IntRAM.stp
Altera/TA12_digitizer/Input data.stp
Altera/TA12_digitizer/Ether.stp
Altera/TA12_digitizer/Digitizer.stp
