EpsLeonid/lxe-twr/Altera/TA6_digitizer/sopc_builder_log.txt

Info: Saving your IP search path in C:\Users\epshtein\.altera.quartus\ip\9.1sp2\ip_search_path\user_components.ipx
Info: Using factories: CuspFactory, ImportFactory, DSPBuilderFactory, EmbeddedSwTclDriverFactory, JarFactory, TclModuleFactory, SopcXmlFactory, MegaVariationFactory, BeanElementFactory, LegacyFactory, DDRLegacyFactory, PresetFactory
Progress: (0) searching D:/Users/Leon/Work/CMD-3/el_lxe/Electronics/trunk/Altera/TA6_digitizer/9.1sp2 (command line switch)
Info: D:/Users/Leon/Work/CMD-3/el_lxe/Electronics/trunk/Altera/TA6_digitizer/9.1sp2 matched 1 files in 0,00 seconds
Info: Found 0 components
