EpsLeonid/lxe-twr/CSA_new/LXeTwr-CSA2_all.pdf

D

1 | 2 | 3 | 4

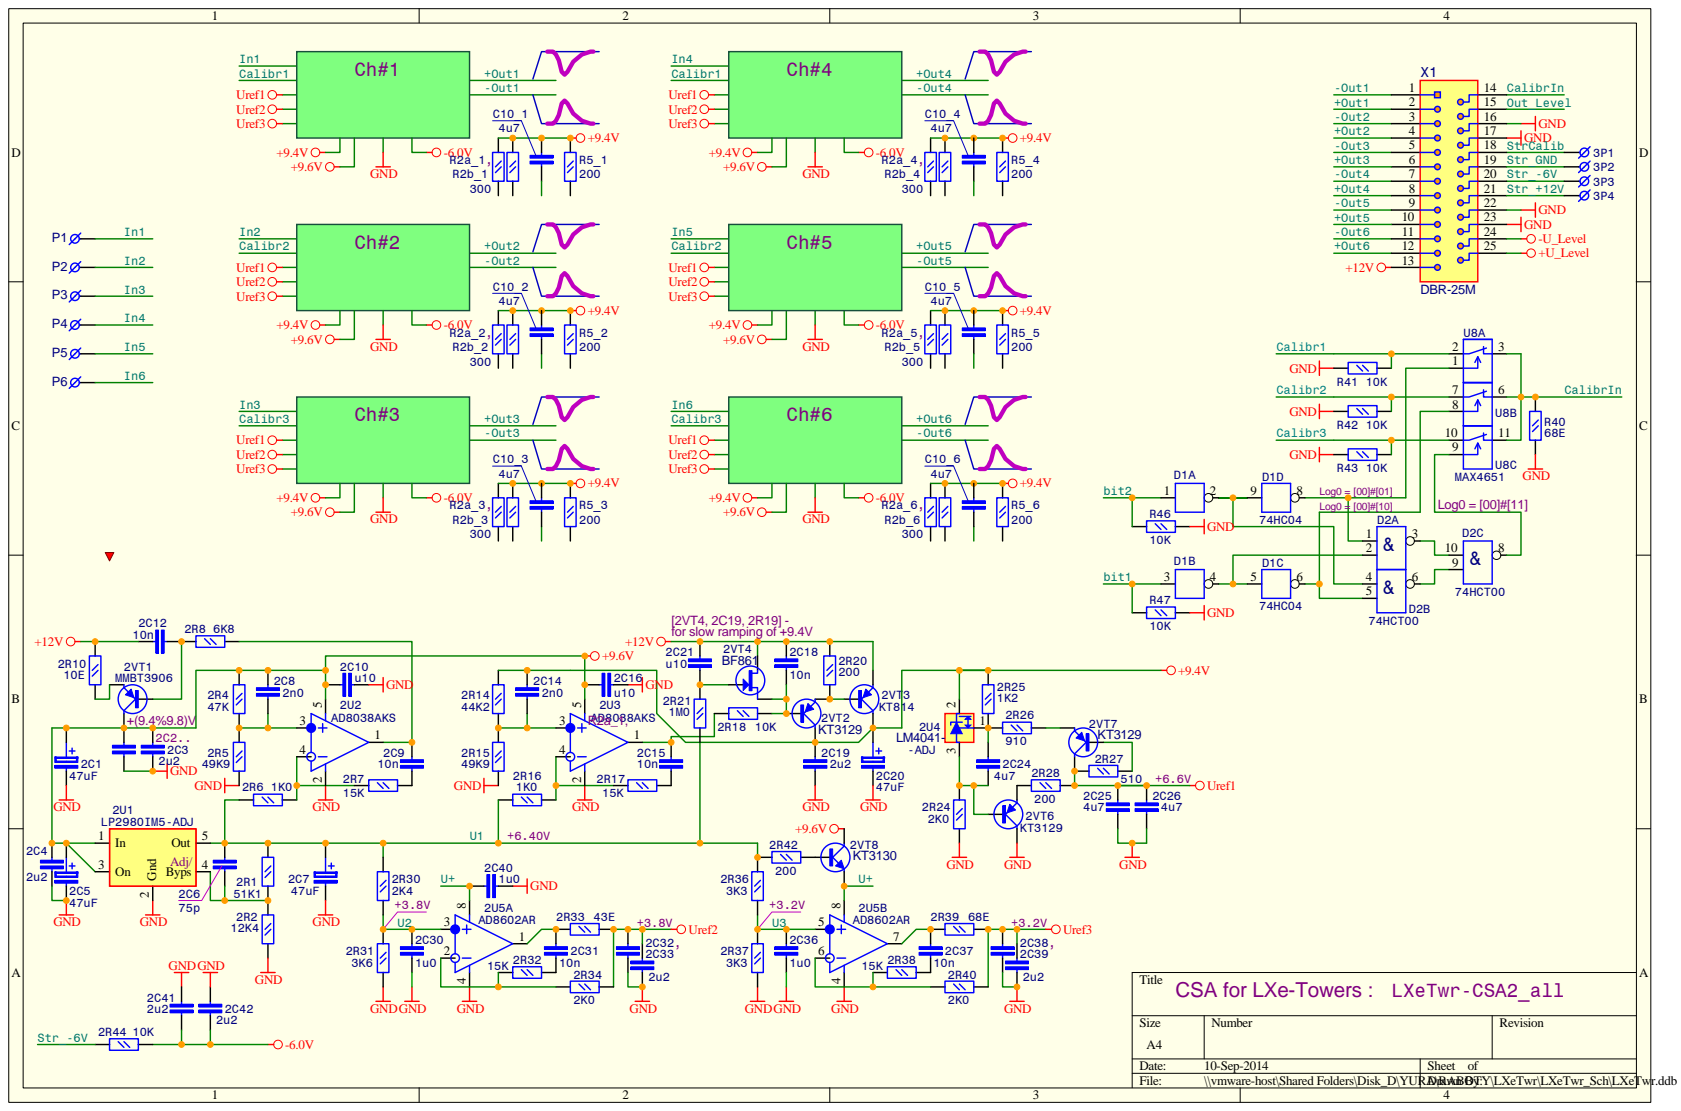
[picture p2: page 1]

[2VT4, 2C19, 2R19] - for slow ramping of +9.4V

CSA for LXe-Towers : LXeTwr-CSA2_all
