EpsLeonid/lxe-twr/CSA_new/LXeTwr-CSA2_ch.pdf

D

1 | 2 | 3 | 4

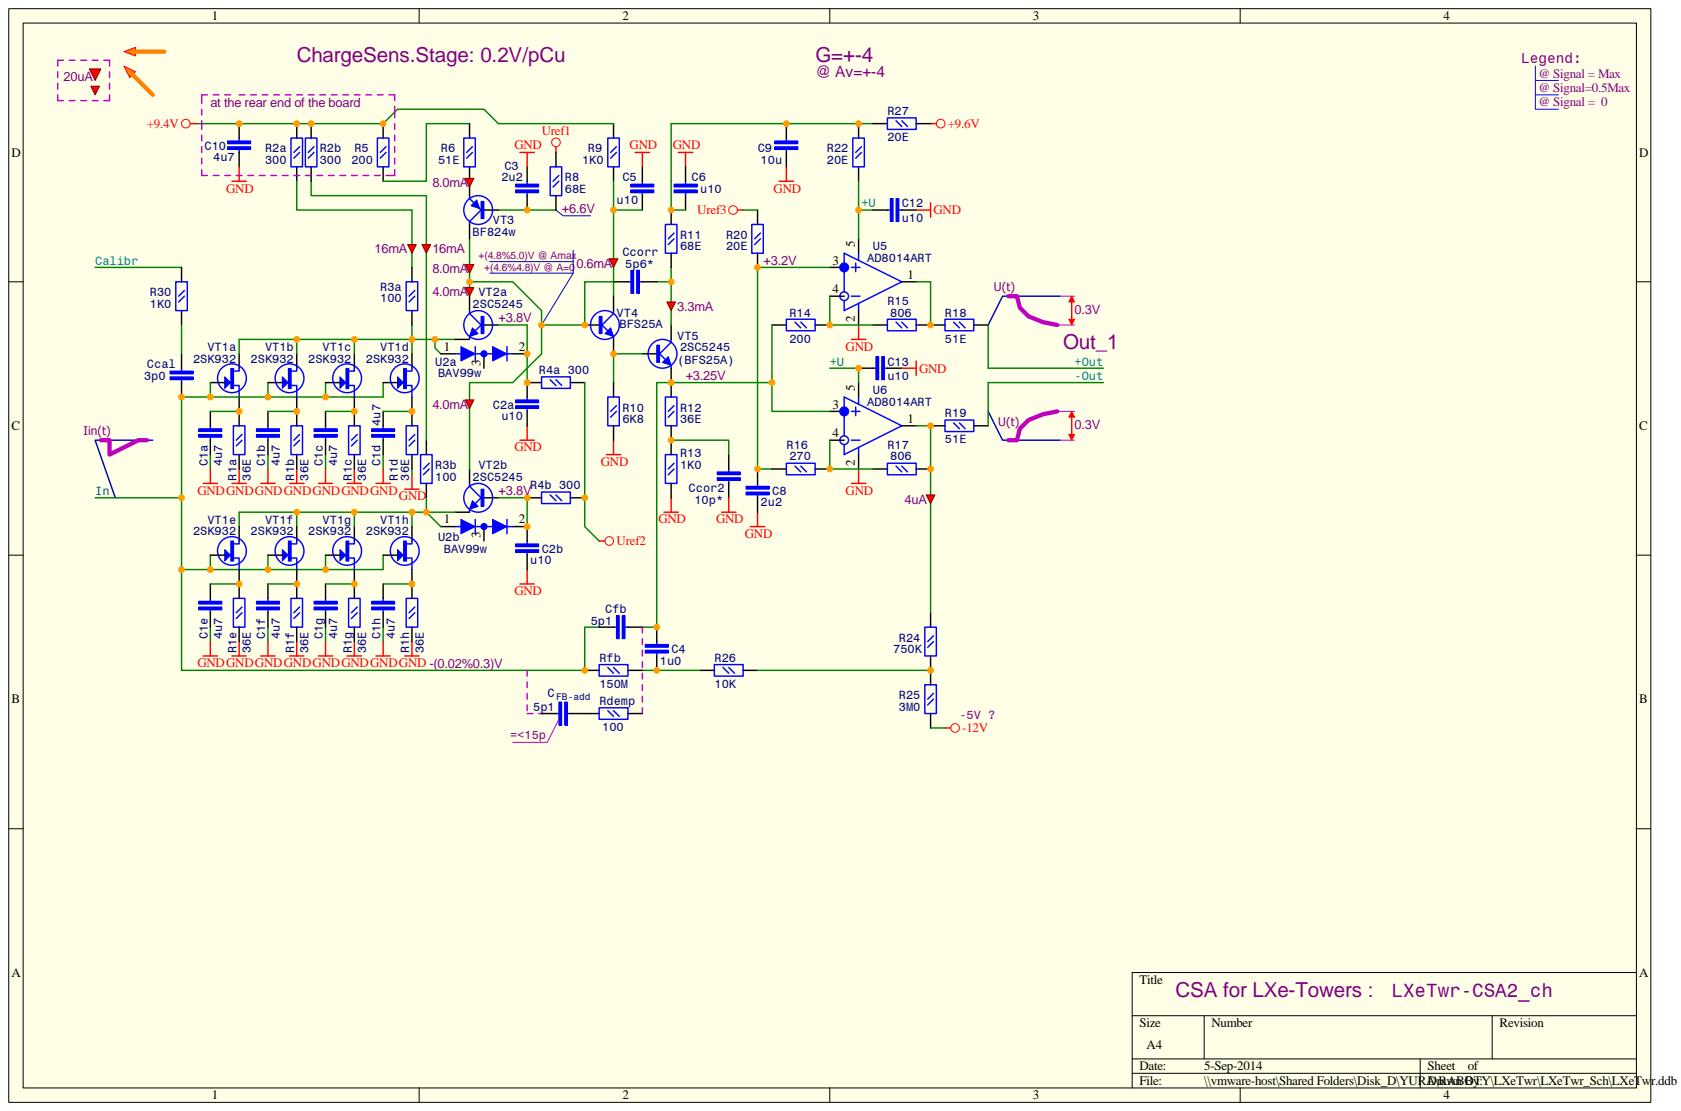
[picture p3: page 1]

at the rear end of the board

CSA for LXe-Towers : LXeTwr-CSA2_ch
