EpsLeonid/lxe-twr/LXe_digitizer/Digit_ch.pdf

## AD8039 (SOT-23-8, RT-8) Csh1

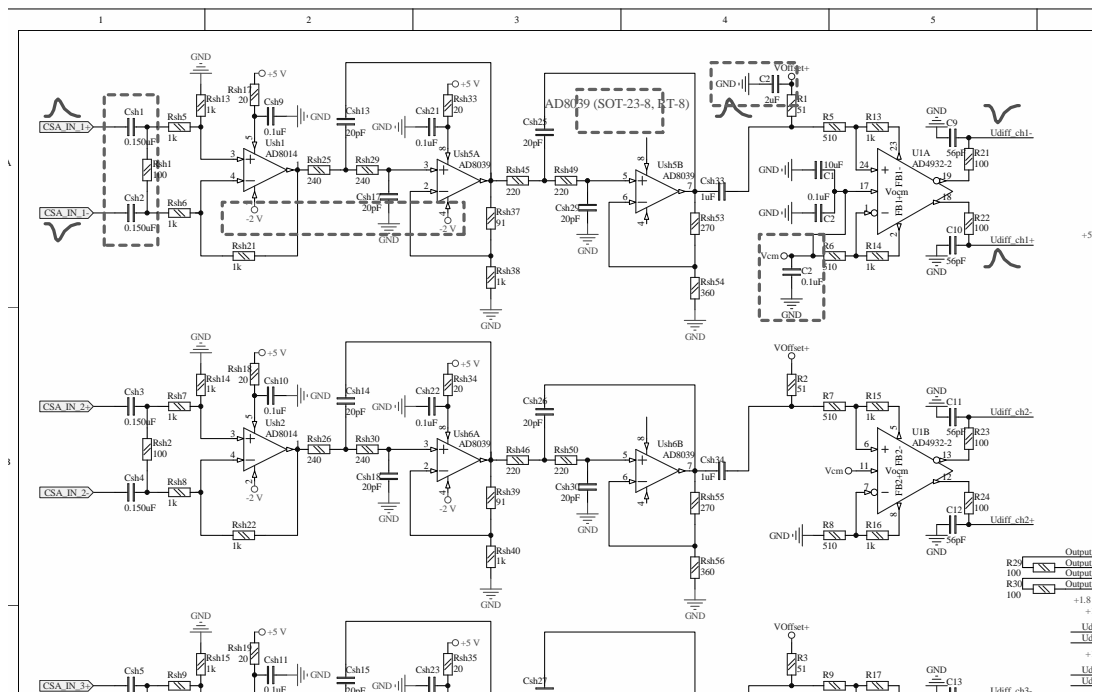
[picture p4: page 1]
