EpsLeonid/lxe-twr/LXe_digitizer/LXe_digitizer.pdf

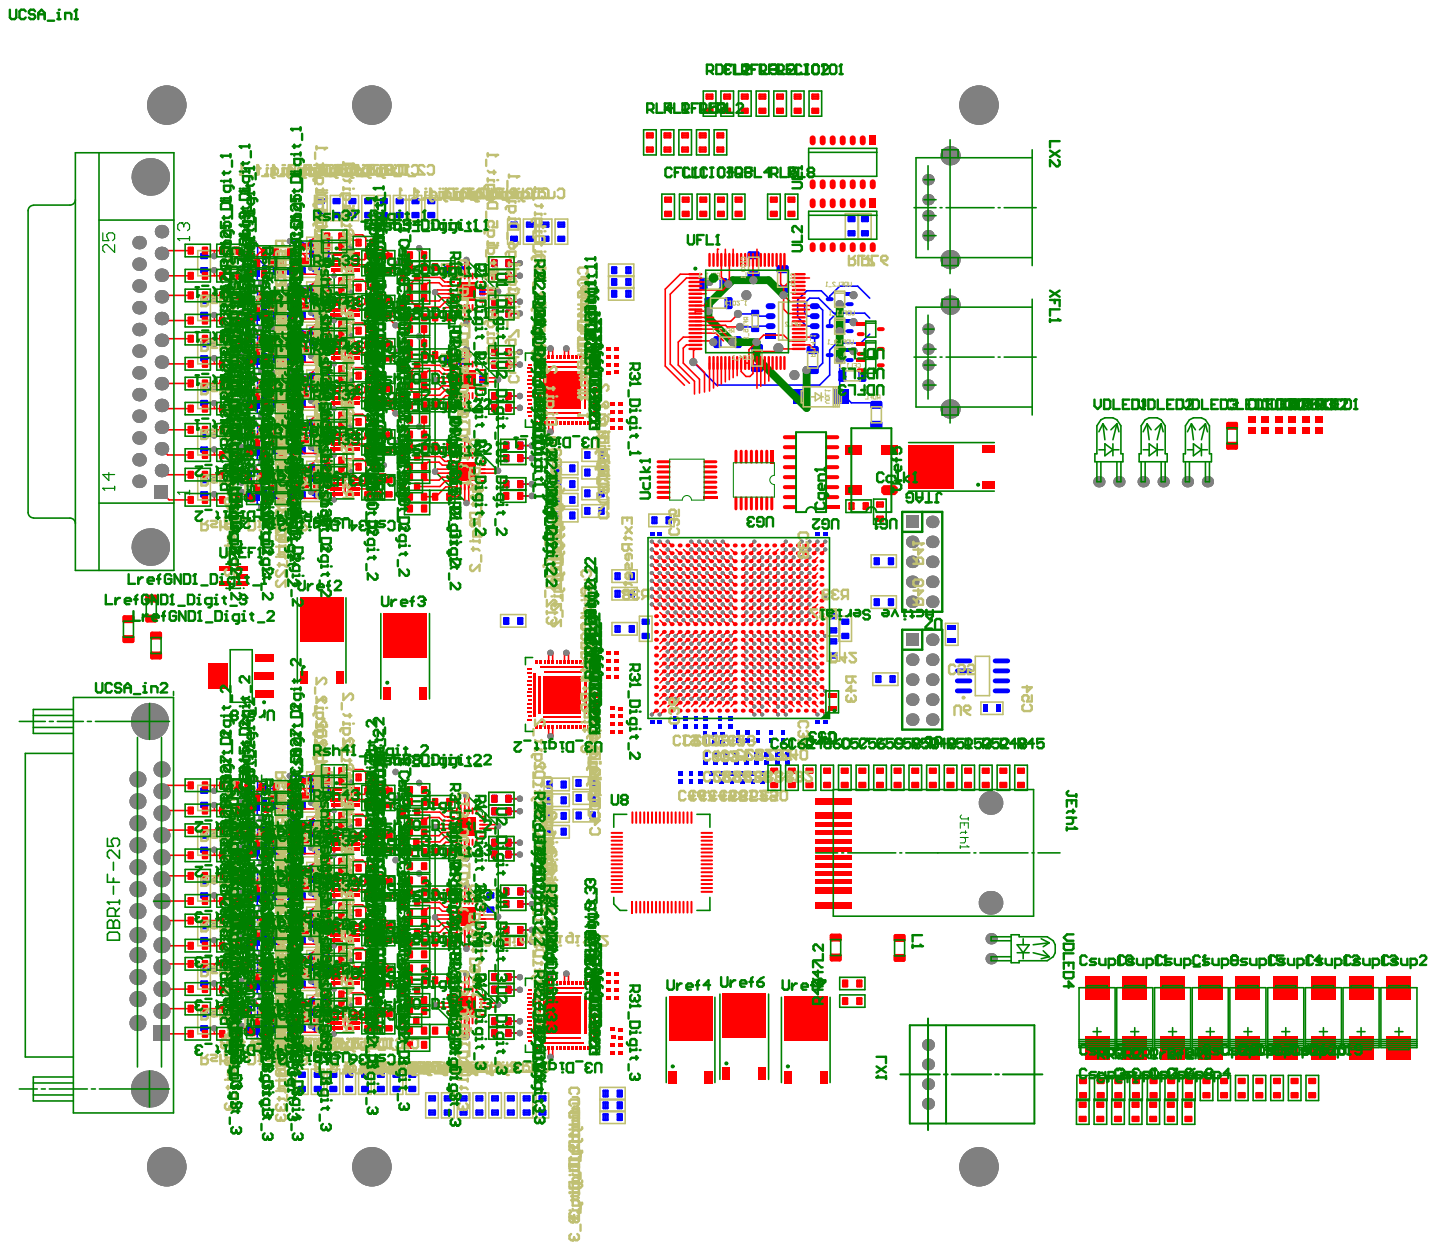
[picture p5: page 1]
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
