EpsLeonid/lxe-twr/LXe_digitizer/Lxe_twr_4ch_bottom.pdf

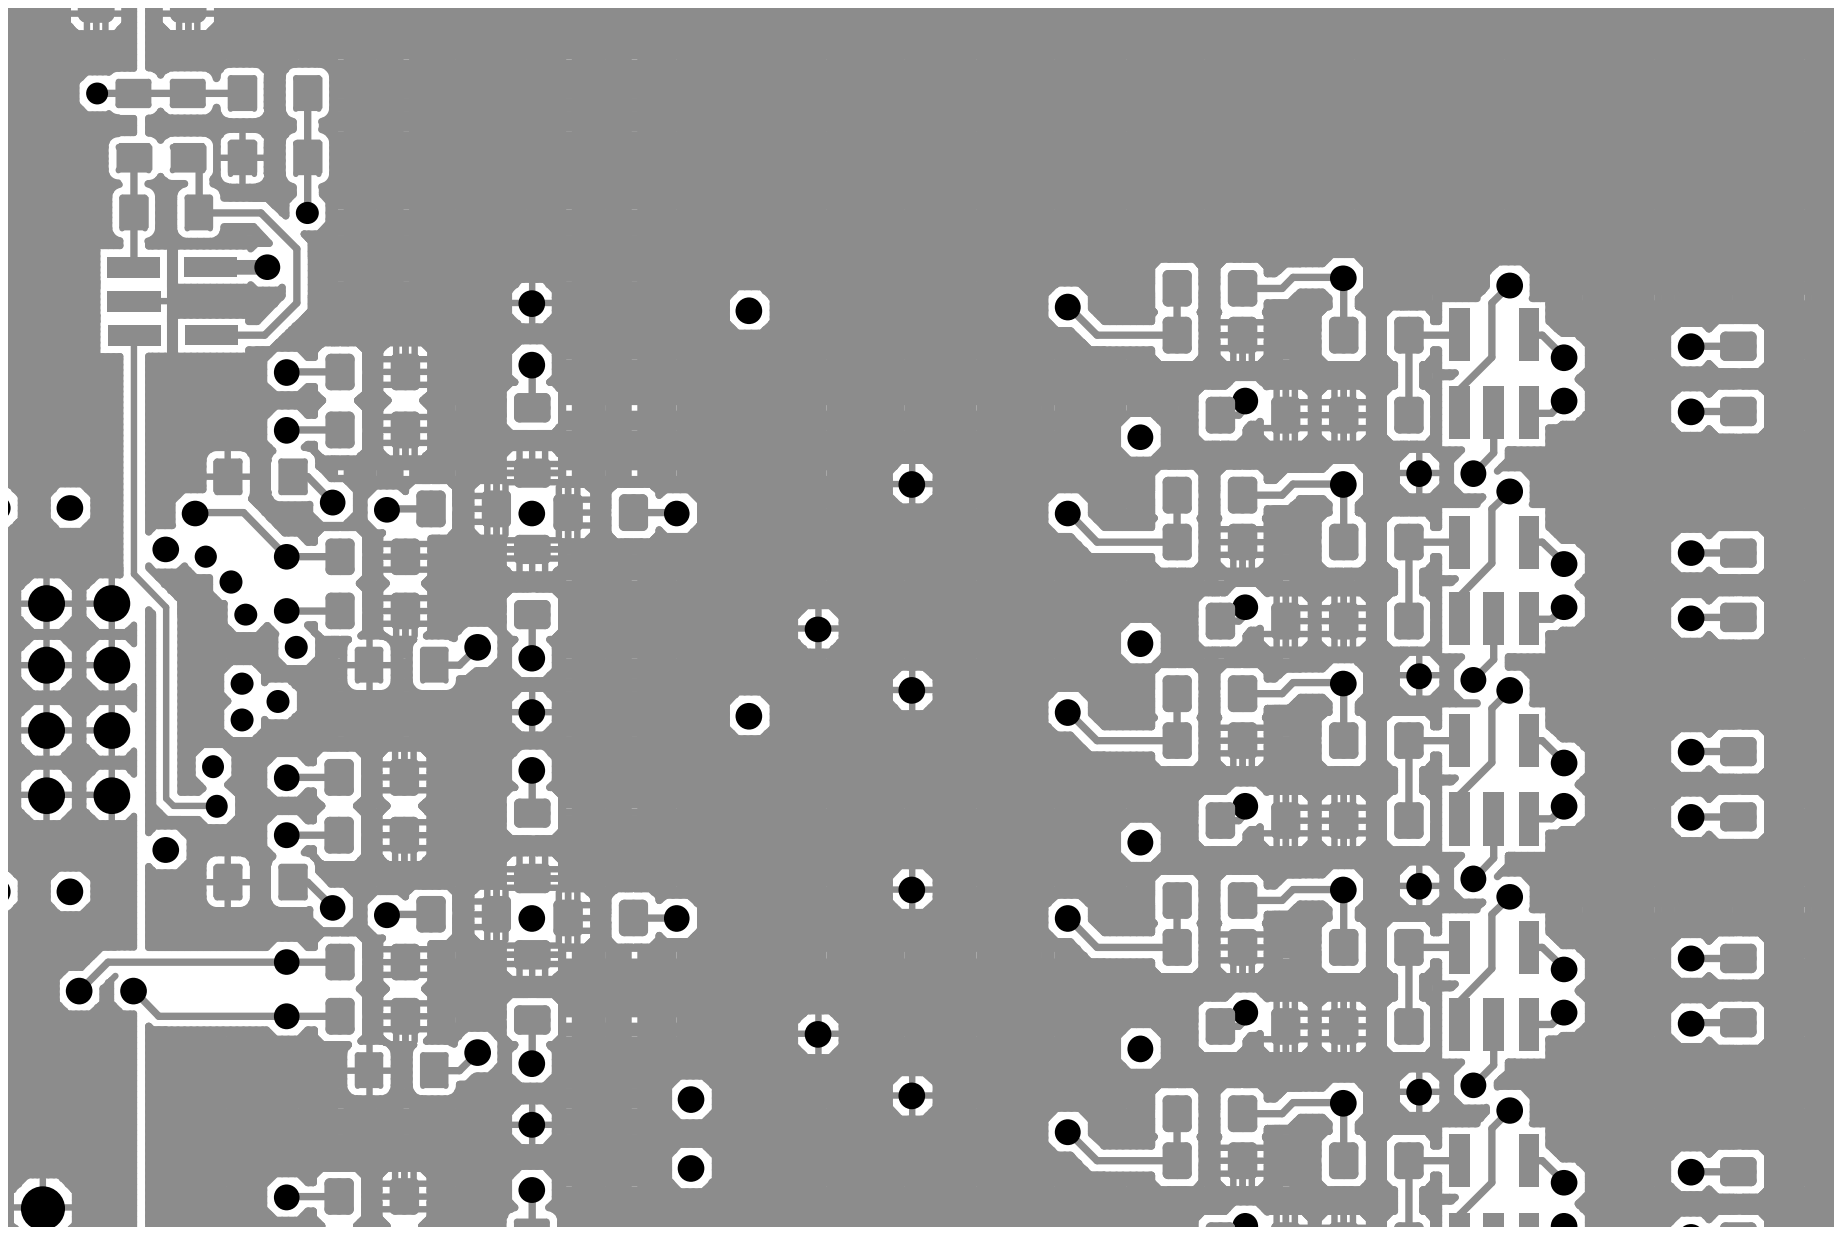
[picture p6: page 1]
