EpsLeonid/lxe-twr/LXe_digitizer/Lxe_twr_4ch_top.pdf

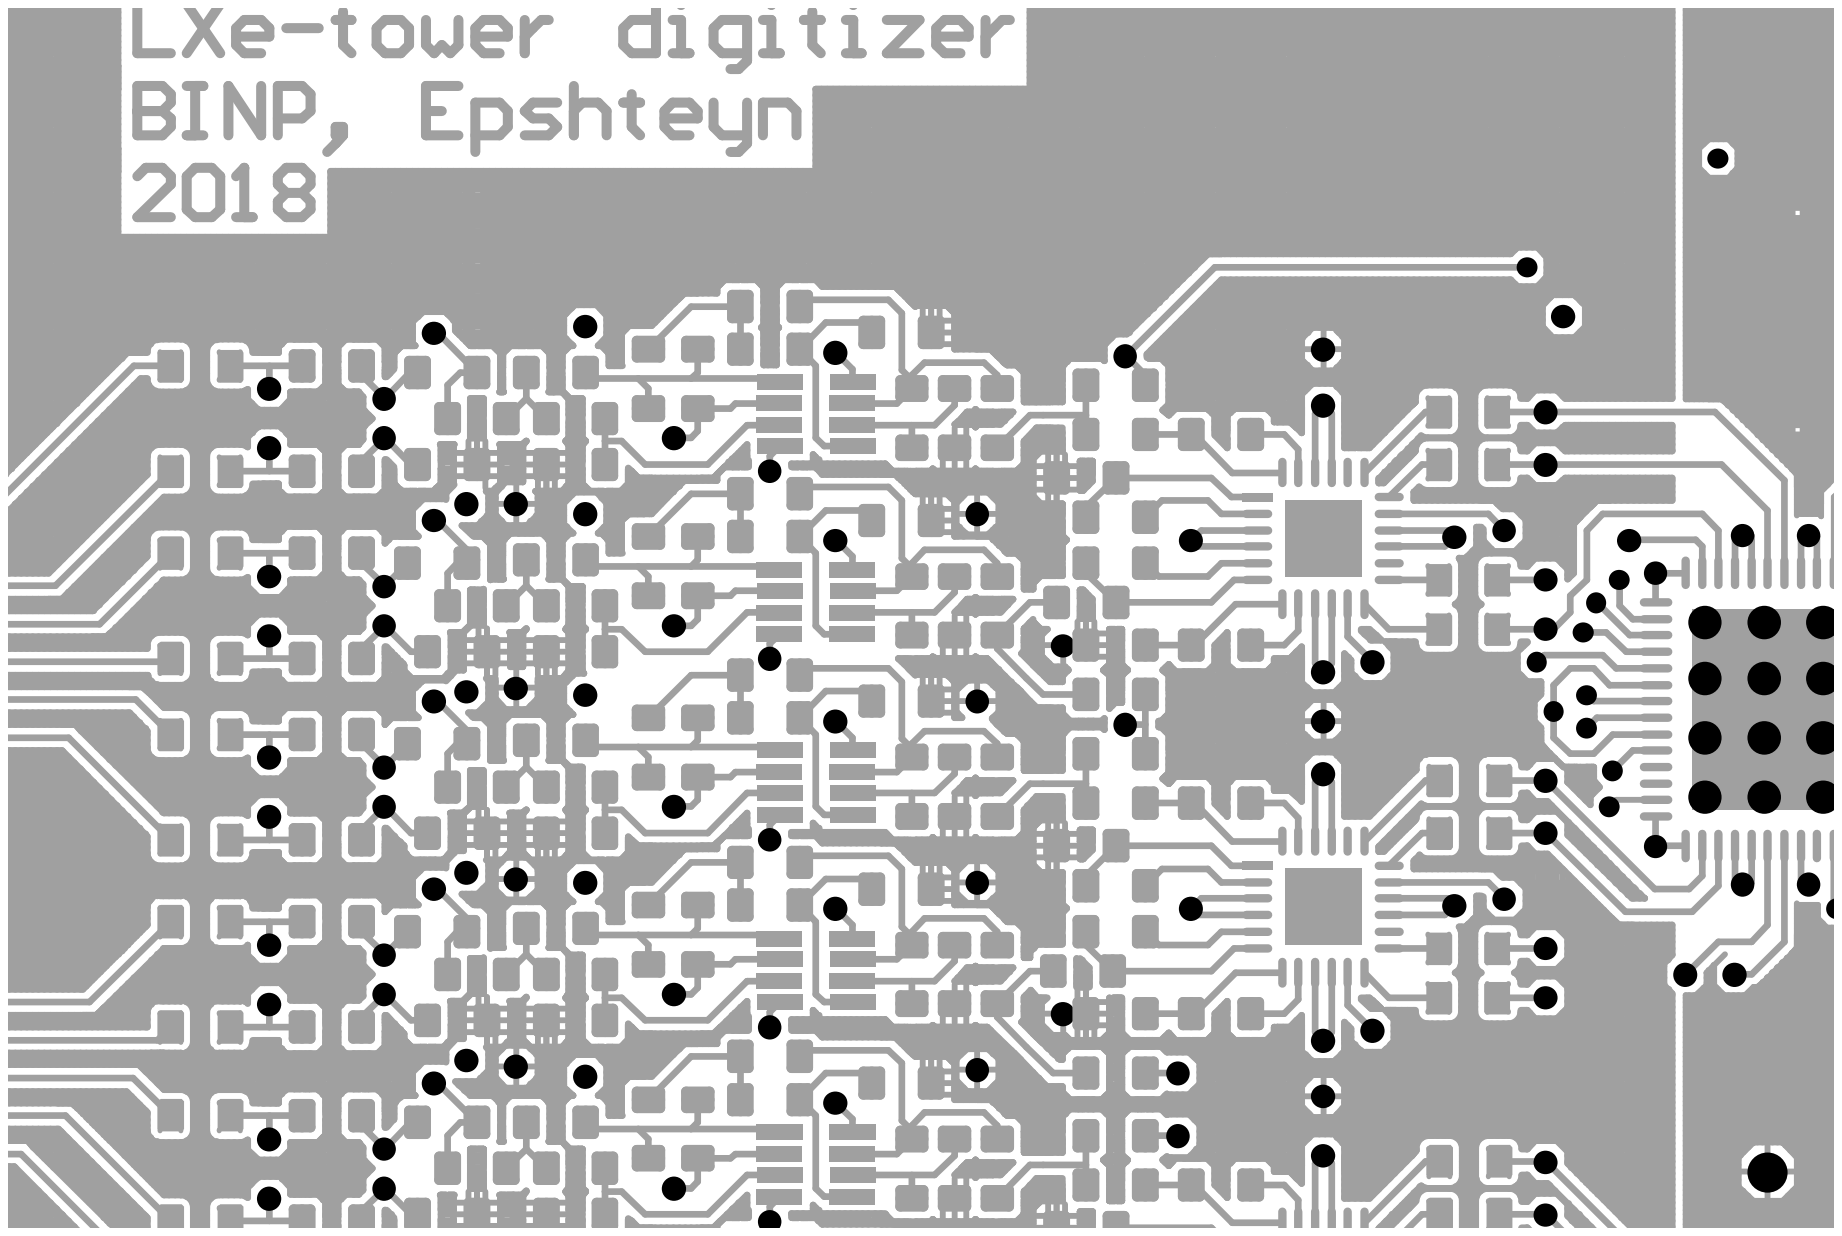
[picture p7: page 1]
