EpsLeonid/lxe-twr/CSA_new/LXeT2_x6-mont_bot1.pdf

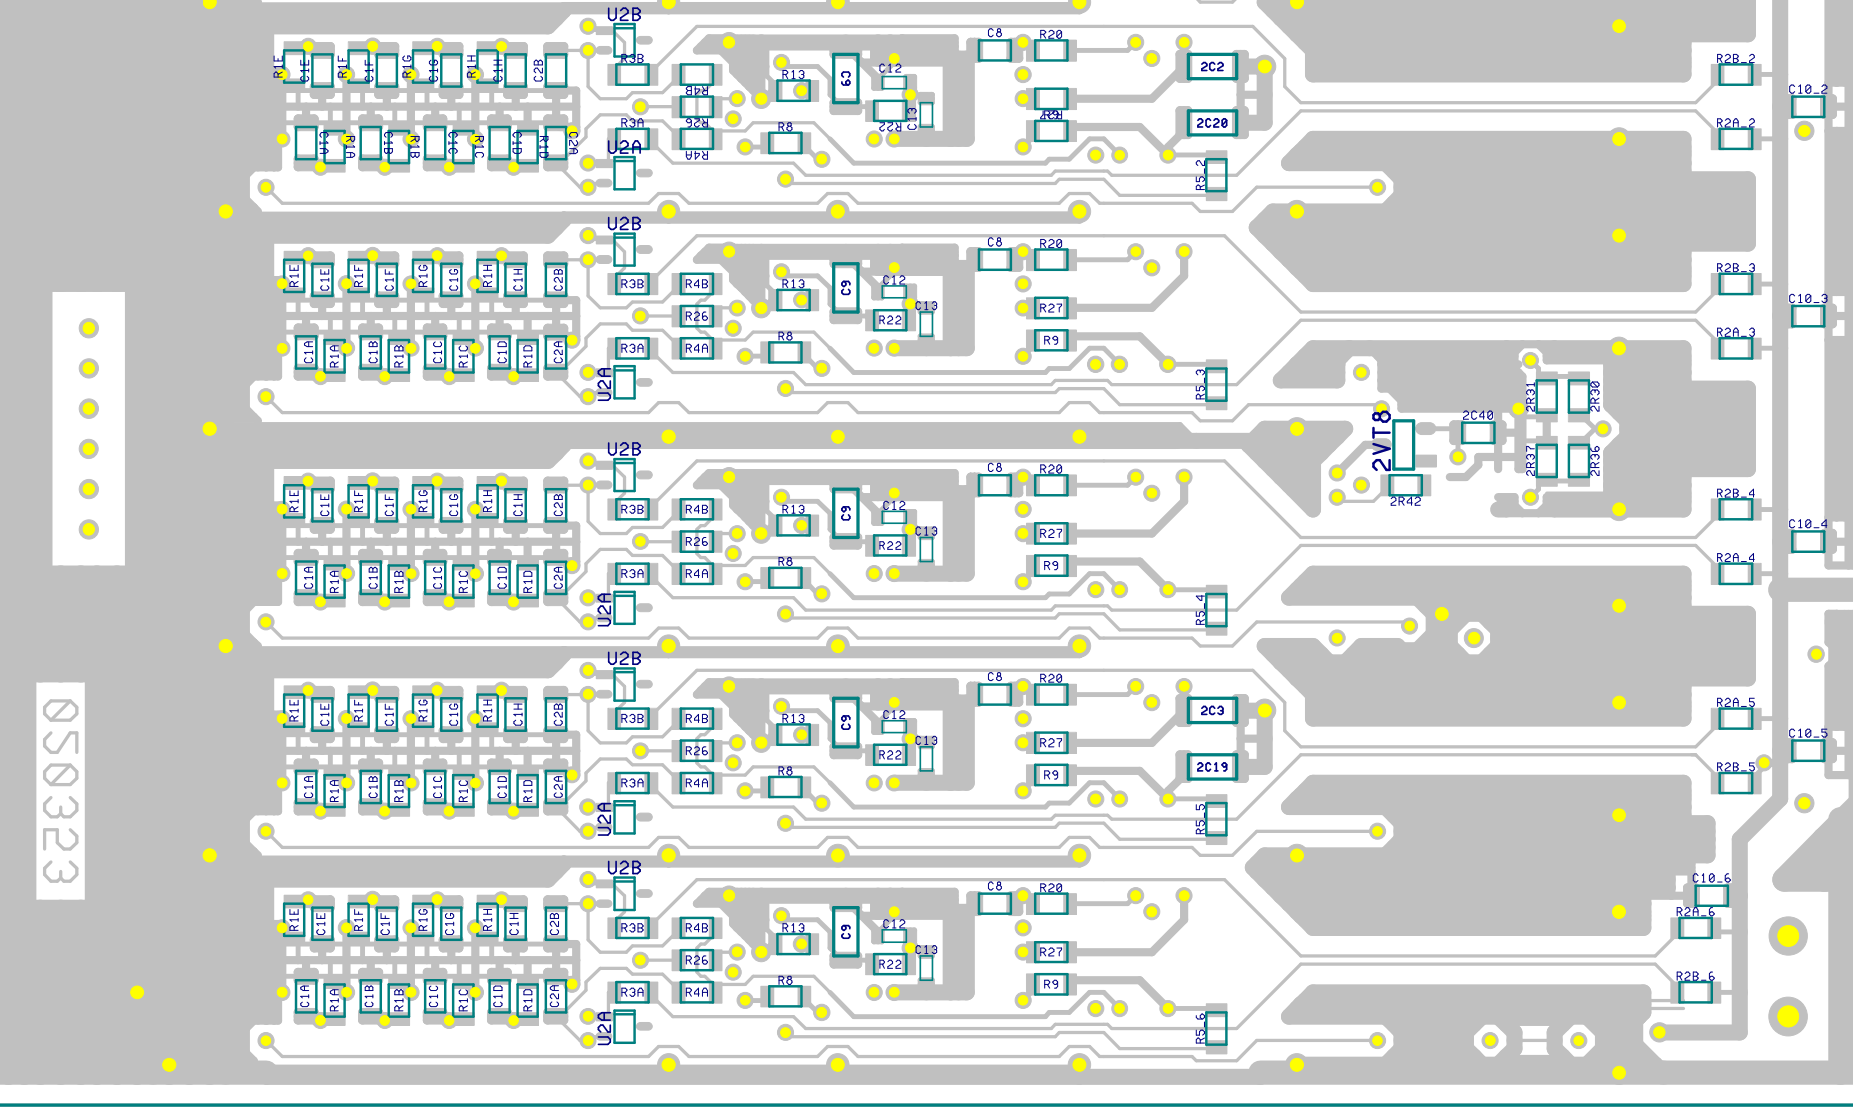
[picture p8: page 1]
