EpsLeonid/lxe-twr/CSA_new/LXeT2_x6-mont_bot2.pdf

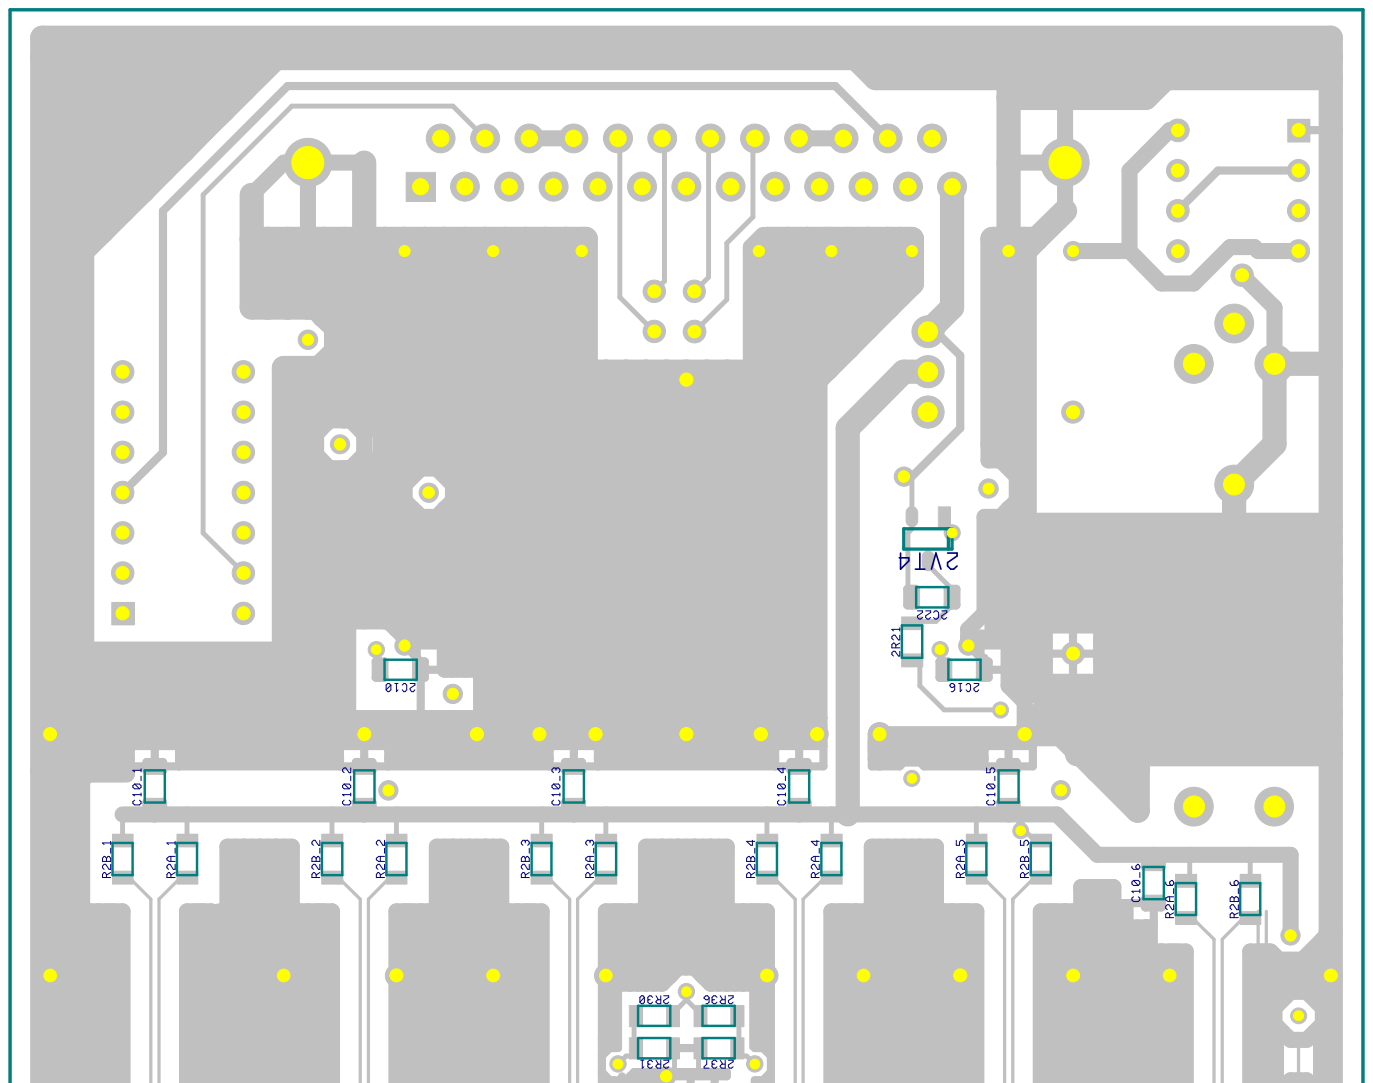
[picture p9: page 1]
