EpsLeonid/lxe-twr/CSA_new/LXeT2_x6-mont_top1.pdf

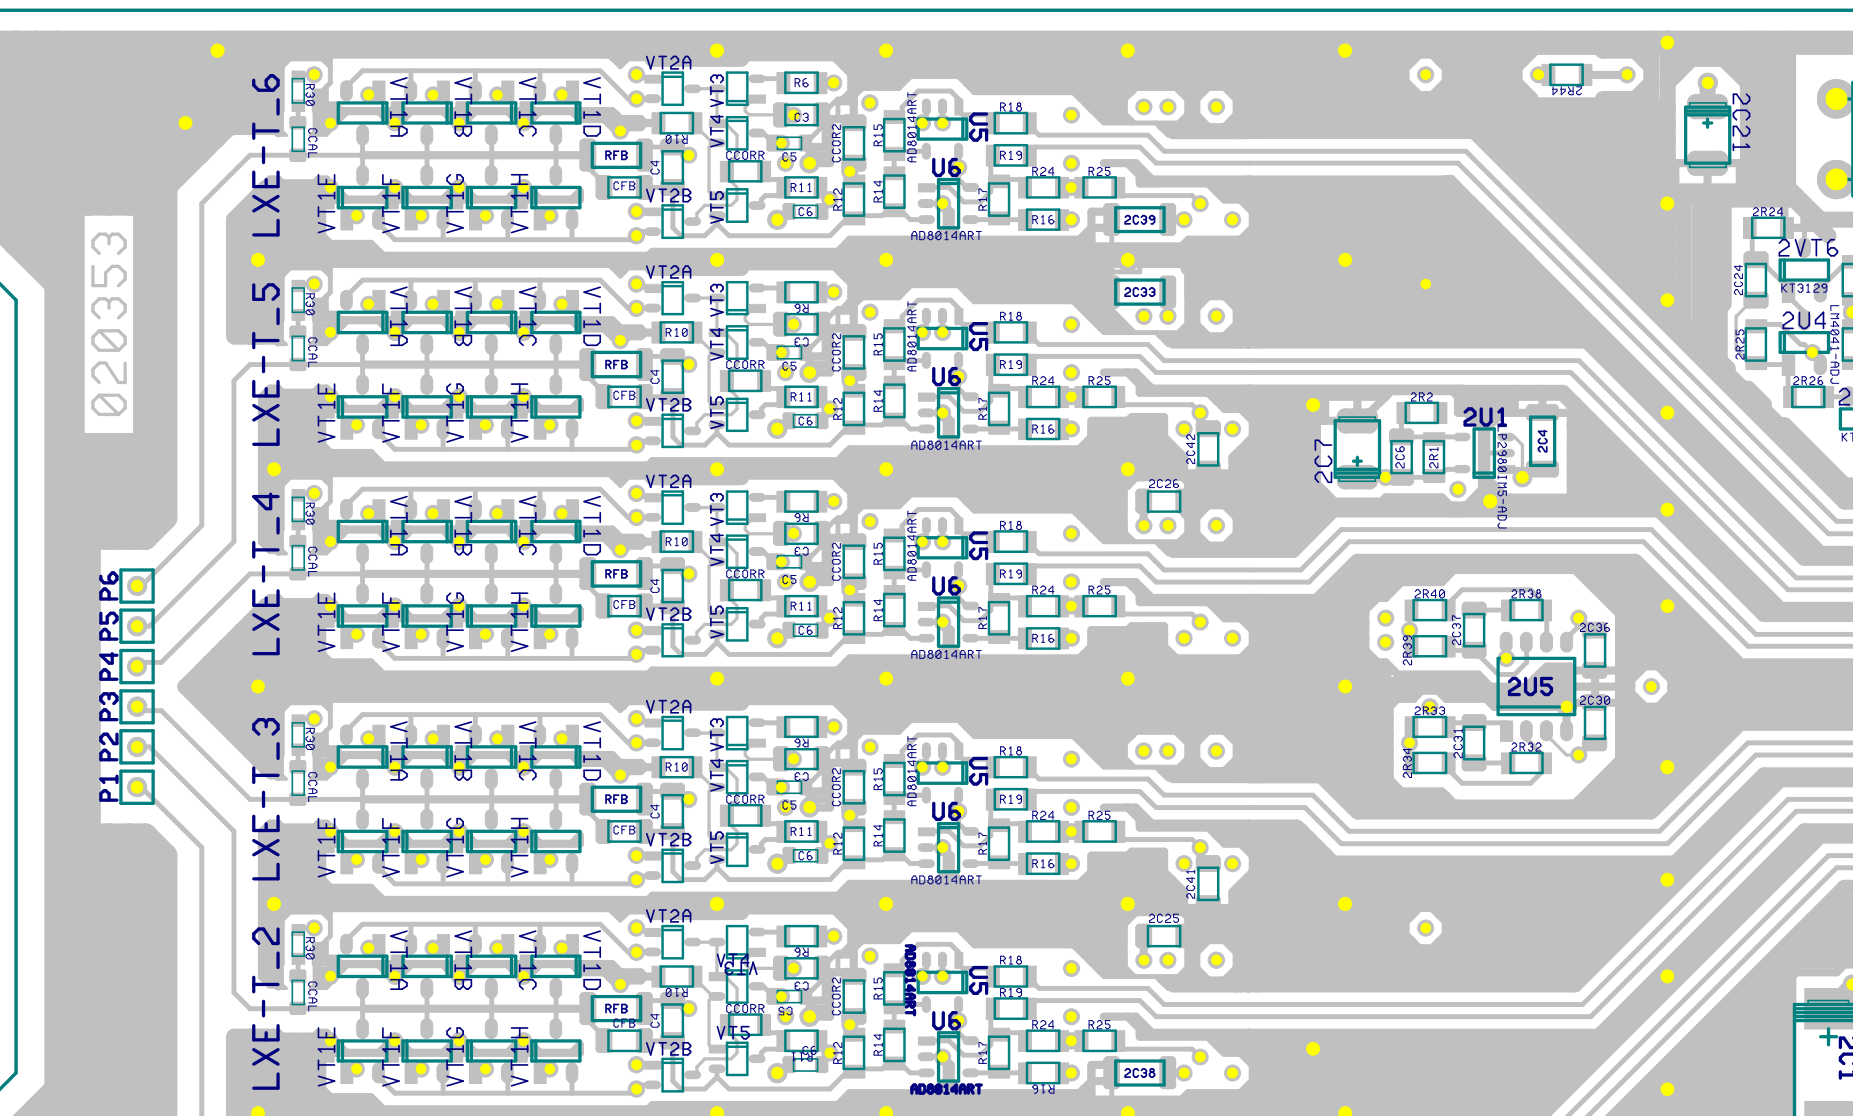
[picture p10: page 1]
