EpsLeonid/lxe-twr/CSA_new/LXeT2_x6-mont_top2.pdf

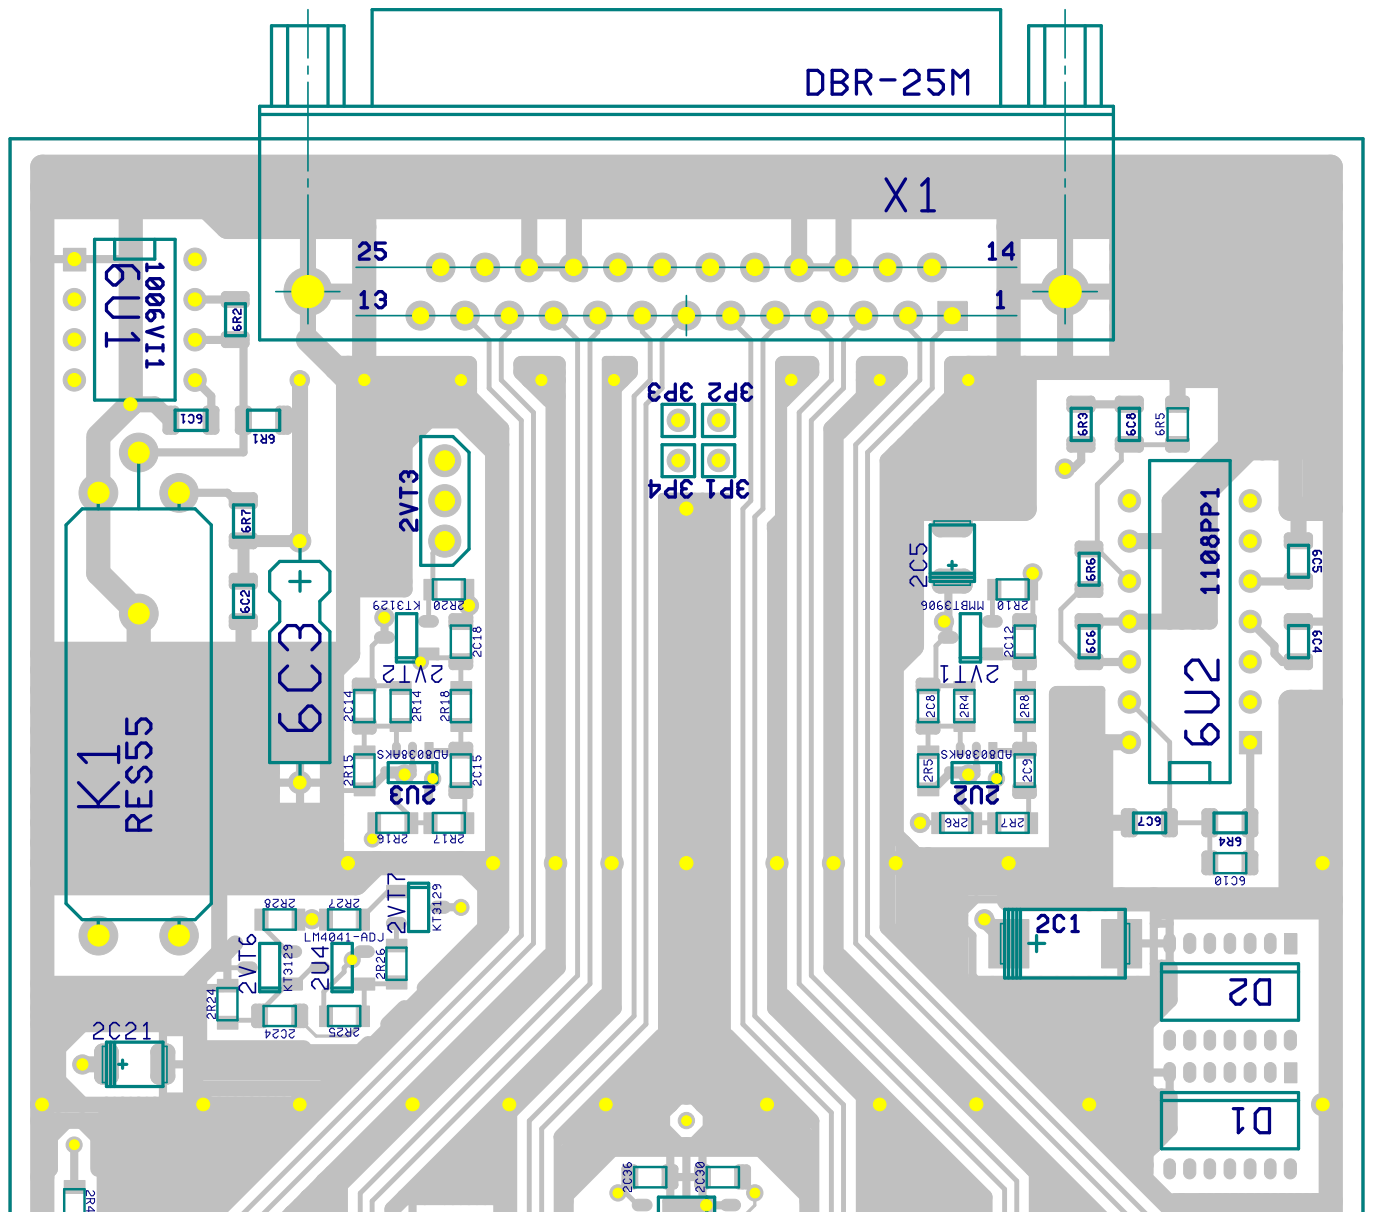
[picture p11: page 1]
