EpsLeonid/lxe-twr/(list of files, drawings)

Other design files:
ADIS/ADIS(Fin0)/ADIS(Fin0).PrjPcb
ADIS/ADIS(Fin0)/ADIS.Pcb
ADIS/Backup of ADIS.Pcb
ADIS/Backup of PCB1.PCB
ADIS/MyLib.PcbLib
ADIS/MyLib.SchLib
ADIS/Previous Backup of ADIS.Pcb
ADIS/Previous Backup of PCB1.PCB
IPT-LXe/CAMAC.SchDoc
IPT-LXe/CAMAC_v2.SchDoc
IPT-LXe/Ethernet.SchDoc
IPT-LXe/FPGA.SchDoc
IPT-LXe/In-Out.SchDoc
IPT-LXe/IPT-LXe Bottom.SchDoc
IPT-LXe/IPT-LXe Top.SchDoc
IPT-LXe/IPT-LXe.dsn
IPT-LXe/IPT-LXe.PrjPCB
IPT-LXe/Main schem.SchDoc
IPT-LXe/Ref&Supply Unit.SchDoc
IPTD/IPTD.SchDoc
IPTD/IPTD_Project.PrjPcb
LXe_digitizer/Analog.SchDoc
LXe_digitizer/CSA.SchDoc
LXe_digitizer/Digit.SchDoc
LXe_digitizer/Digit_2.SchDoc
LXe_digitizer/Ethernet.SchDoc
LXe_digitizer/FLink Unit.SchDoc
LXe_digitizer/In-Out.SchDoc
LXe_digitizer/LXe_digitizer.PrjPcb
LXe_digitizer/Main schem.SchDoc
LXe_digitizer/New_LXe_twr-4.PcbDoc
LXe_digitizer/New_LXe_twr.PcbDoc
LXe_digitizer/Processing Unit.SchDoc
LXe_digitizer/Ref&Supply Unit.SchDoc
LXe_digitizer/SLink Unit.SchDoc
LXe_digitizer/SRAM.SchDoc
LXe_digitizer/Timing Unit.SchDoc
Module16x16_Communication_board (18.05.2012 14-53-22)/Communication_board.PcbDoc
Module16x16_Communication_board (18.05.2012 14-53-22)/DigitalPart.SchDoc
Module16x16_Communication_board (18.05.2012 14-53-22)/Ethernet.SchDoc
Module16x16_Communication_board (18.05.2012 14-53-22)/FPGA.SchDoc
Module16x16_Communication_board (18.05.2012 14-53-22)/Misc.SchDoc
Module16x16_Communication_board (18.05.2012 14-53-22)/Module16x16_Communication_board.PrjPCB
Module16x16_Communication_board (18.05.2012 14-53-22)/Power.SchDoc
Module16x16_Communication_board (18.05.2012 14-53-22)/PowerMeasure.SchDoc
UniversalFinder v2 (10.01.2014 11-53-50)/UniversalFinder v2 for NEC.pcb
UniversalFinder v2 (10.01.2014 11-53-50)/UniversalFinder v2.pcb
UniversalFinder v2 (10.01.2014 11-53-50)/UniversalFinder v2.PrjPcb
