EpsLeonid/lxe-twr/(commit log)

2017-04-14 Передача данных из ИПТ работает. Что-то передается из ТА6 в ИПТ.
2017-06-16 Рабочая версия передачи данных в 3 пакета по 193 команде. По 210-й команде данные сдвинуты на 2 слова.
2020-01-28 Файлы 2019-го года с задержкой для изернета 240 тактов. 2020-го 220 тактов.
